vitorr-hugoo/TCC/tools/README.md

# Ferramentas

- `hardware/`: scripts de apoio e validacao do KiCad.
- `documentos/`: geradores de documentos e figuras.
- `codex/skills/`: instrucoes reutilizaveis para automacao assistida.

Scripts devem receber ou resolver caminhos dentro do repositorio; resultados
intermediarios devem ser gravados em `../work/`.
