vitorr-hugoo/TCC/docs/engineering/firmware/stm32/reports/004-lora-transicao-standby.md

# LoRa: confirmação da transição para Standby

Após corrigir NSS para PB12, a bancada apresentou `RegVersion=0x12` e
`CONFIG: reg=0x01 esperado=0x81 lido=0x80`. O registrador é RegOpMode:
o firmware pediu LoRa Standby, mas leu LoRa Sleep. Isso localiza a falha;
não comprova, sozinho, defeito elétrico ou atraso de transição.

O driver verificava todas as escritas imediatamente, incluindo mudança de
modo. A saída de Sleep envolve partida do oscilador, descrita no
[datasheet Semtech SX1276/77/78/79](https://cdn-shop.adafruit.com/product-files/3179/sx1276_77_78_79.pdf).
A hipótese a verificar na placa é leitura antes de concluir a transição.

Alteração: após escrever RegOpMode, consultar sua confirmação a intervalos
de 1 ms, com prazo de 10 ms e limite adicional de consultas. O comando é
escrito uma vez; os demais registradores mantêm verificação imediata.
Erro SPI aborta imediatamente. Se não confirmar, mantém CONFIG, mostra
esperado/lido e não habilita transmissão. Os timeouts SPI permanecem
independentes, portanto uma operação SPI em falha pode levar mais que 10 ms.

Validação nativa: 54/54 cenários LoRa aprovados, incluindo quatro novos:
modo atrasado que confirma, modo preso em Sleep, erro SPI durante espera
e timeout atravessando rollover do relógio. Esses testes não reproduzem o
oscilador físico; confirmar gravando o firmware na placa.

Se continuar lendo 0x80 depois do prazo, investigar alimentação, RESET e
oscilador/configuração de clock do módulo, sem simplesmente ampliar o prazo
ou ignorar a verificação. Sem commit, push, alteração do pacote ou ACK.

Builds ARM Debug e Release concluídos sem erros; permanece apenas o aviso anterior do FatFs em ff.c:5032.

## Retorno da bancada

O usuario confirmou inicializacao LoRa bem-sucedida e validou o TX do STM32 apos o ajuste. O log apresentou `Init OK` e `TX concluida pelo radio | seq=0 | len=18 | motivo=OK`. Mantido o prazo de 10 ms para confirmacao da transicao; ele nao e atraso fixo. Essa validacao confirma o caminho local de TX, sem constituir ACK de entrega do gateway.
