vitorr-hugoo/TCC/docs/tcc/fontes/Projeto_alimentacao_VRLA_TCC.docx

# Projeto de alimentacao para placa de TCC com bateria VRLA AGM

Documento de arquitetura, circuitos de referencia, seguranca e implementacao no KiCad

Versao atualizada para bateria chumbo-acida regulada por valvula, 12 V, tipo AGM

Decisao de projeto. A referencia deste documento e uma bateria VRLA AGM de 12 V e 7 Ah, instalada fora da area mais quente da caixa. O painel solar e uma fonte externa de 15 a 18 Vcc alimentam um carregador discreto. A bateria fornece o barramento VSYS, que varia com o estado de carga; a placa gera 5 V e 3,3 V a partir dele.

Limite de escopo. Nao ha rede CA dentro da PCB. A energia eletrica externa deve chegar por uma fonte AC/DC certificada, em baixa tensao continua. Valores de carga e protecao devem ser confirmados na folha de dados da bateria adquirida.

Leitura recomendada: comece pela arquitetura na pagina seguinte, depois escolha a bateria real e ajuste o carregador e o corte por subtensao. As notas [R1] a [R7] aparecem explicitamente nas secoes tecnicas e sao listadas ao fim.

# 1 Arquitetura recomendada

O encadeamento correto nao e painel solar ou fonte de 12 V -> buck -> bateria. Uma VRLA de 12 V exige tensao de carga maior que 12 V. Por isso, as fontes entram primeiro em um carregador dedicado; a bateria fica entre o carregador e os reguladores da placa. O carregador e construido com CI, MOSFETs, indutor, passivos e sensores na propria PCB, sem modulo pronto.

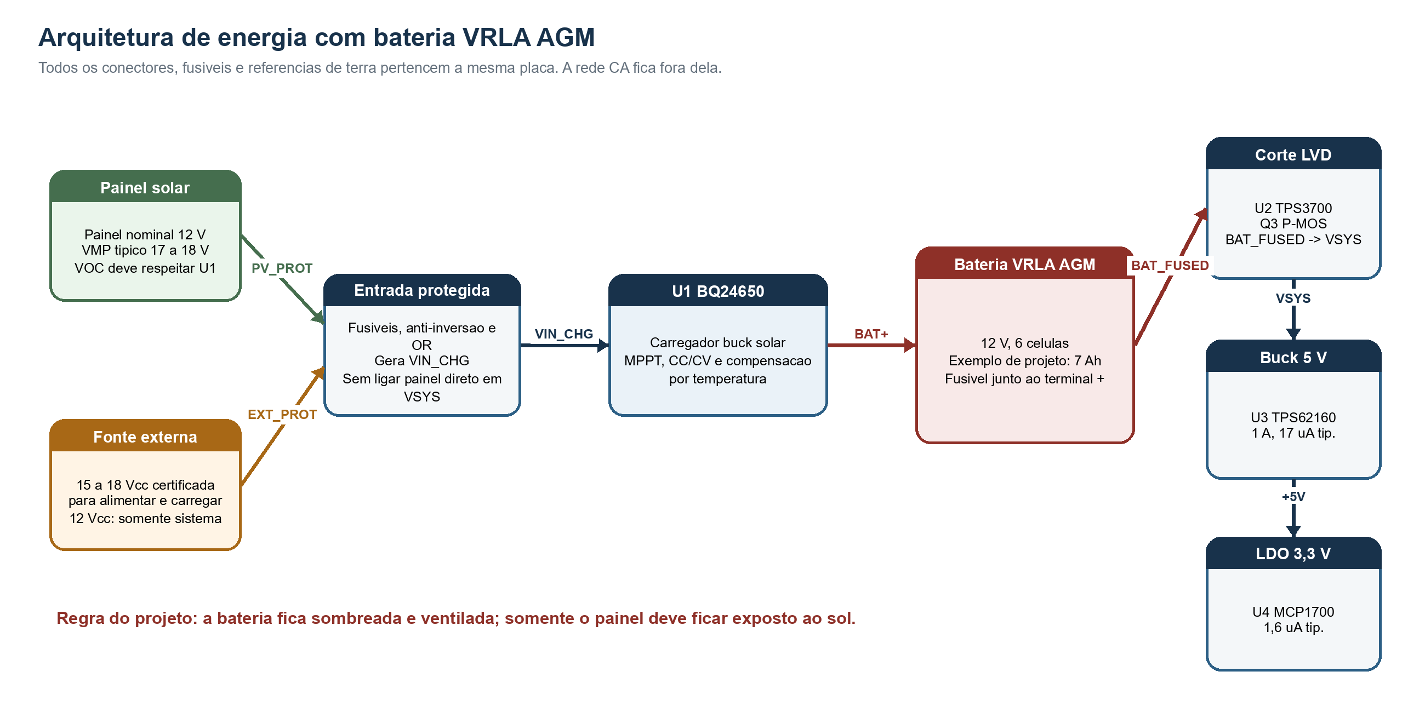
[picture p14: figure]

Figura 1 - Fluxo de energia e nomes dos barramentos. A exposicao solar e exclusiva do painel; a bateria deve permanecer sombreada e ventilada.

Ponto que muda em relacao a Li-ion. Desaparecem o BMS 3S e o balanceamento de celulas, mas surgem tres itens obrigatorios: perfil de carga bulk/recharge adequado, compensacao por temperatura e corte de descarga profunda. A VRLA ainda pode liberar gas pela valvula em condicao anormal de carga; portanto nao deve ficar em um compartimento hermetico. Ver [R3] e [R4].

## 1 1 Barramentos e faixas de tensao

Rede | Faixa esperada | Funcao | Observacao
VIN_CHG | Painel nominal 12 V: VMP tipico 17 a 18 V; VOC conforme painel | Entrada do carregador | Escolher painel cujo VOC maximo fique abaixo de 28 V, limite de entrada de U1 [R1].
BAT+ | Cerca de 10,5 a 14,7 V | Terminal da VRLA | Nao e um 12 V regulado. A tensao depende de carga, descarga e temperatura.
VSYS | Cerca de 11,3 a 14,7 V | Entrada dos reguladores | Sai apos fusivel e LVD. Abaixo do limiar o sistema desliga.
+5V | 5,0 V regulados | Sensores e perifericos de 5 V | Gerado por buck U3.
+3V3 | 3,3 V regulados | MCU, LoRa, SD e logica | Gerado por LDO U4; avaliar dissipacao.

# 2 Bateria VRLA AGM e seguranca

VRLA significa valve regulated lead acid. AGM e uma forma de VRLA em que o eletrólito fica absorvido em manta de fibra de vidro. Ela e mais apropriada que uma bateria inundada para este projeto porque nao exige reposicao de agua e tem invólucro selado, mas continua sendo uma bateria chumbo-acida e possui valvulas de alivio de gas.

## 2 1 Bateria de referencia

Para dimensionar os valores exemplificados, foi usada como referencia uma VRLA AGM 12 V e 7 Ah, similar a Power Sonic PS-1270. Essa bateria e somente um ponto de partida: a marca e o modelo finais governam tensoes, corrente de carga, temperatura e limiares definitivos. A PS-1270 publica 14,1 a 14,4 V para carga ciclica, 13,5 a 13,8 V para flutuacao, corrente inicial maxima de 2,1 A e energia nominal de 84 Wh a 20 h [R3].

Parametro de projeto | Valor de referencia | Como usar
Capacidade | 7 Ah a taxa de 20 h | Usar para estimativa inicial. A capacidade util cai com corrente alta e temperatura baixa.
Corrente bulk inicial | 0,7 A (aprox. C/10) | Escolha conservadora para painel de 20 a 30 W. Fica abaixo do limite de 2,1 A do exemplo [R3].
Tensao bulk/ciclica | 14,4 V a 20 C | Ajustar o divisor VFB do carregador. Nunca aplicar este numero a outra bateria sem conferir seu datasheet.
Tensao de manutencao | 13,7 V a 20 C | Usada como VRECH/FLOAT no algoritmo de pulsos de U1.
Compensacao termica | Usar valor do fabricante | No exemplo PS-1270: -30 mV/C em ciclica e -18 mV/C em flutuacao [R3].

## 2 2 Instalacao fisica segura

- Instalar a bateria fora da PCB e fora da incidencia solar direta, em compartimento sombreado e ventilado. O painel e o elemento que deve receber sol.
- Nao selar a bateria dentro de uma caixa hermetica. Baterias VRLA podem liberar hidrogenio; o fabricante alerta para risco de mistura explosiva e pede que nao sejam colocadas em recipiente fechado [R4].
- Fixar a bateria mecanicamente e manter os terminais protegidos contra contato acidental. Os cabos do positivo devem ser curtos e ter fusivel junto ao terminal positivo.
- Manter a bateria afastada de fontes de calor, do indutor do carregador e de conectores que possam gerar faisca. O NTC de medicao deve tocar a lateral da bateria, nao o ar da caixa.
- Providenciar reciclagem adequada no fim da vida. Chumbo e eletrólito nao devem ser descartados no lixo comum [R4].

Nota termica. A faixa de operacao recomendada para VRLA pela Yuasa e 10 a 30 C, com 20 C como condicao de referencia; temperaturas mais altas reduzem a vida util [R4]. No projeto, bloquear a carga quando a bateria exceder o limite de seu fabricante e registrar essa temperatura no firmware, se houver ADC disponivel.

# 3 Entradas de energia antes do carregador

A folha de alimentacao deve desenhar as entradas a esquerda e os reguladores a direita. Nao usar a rotulacao 12 V para a entrada solar, porque um painel nominal de 12 V trabalha perto de 17 a 18 V no ponto de maxima potencia. O seu VOC pode ser maior e deve ser conferido no painel real.

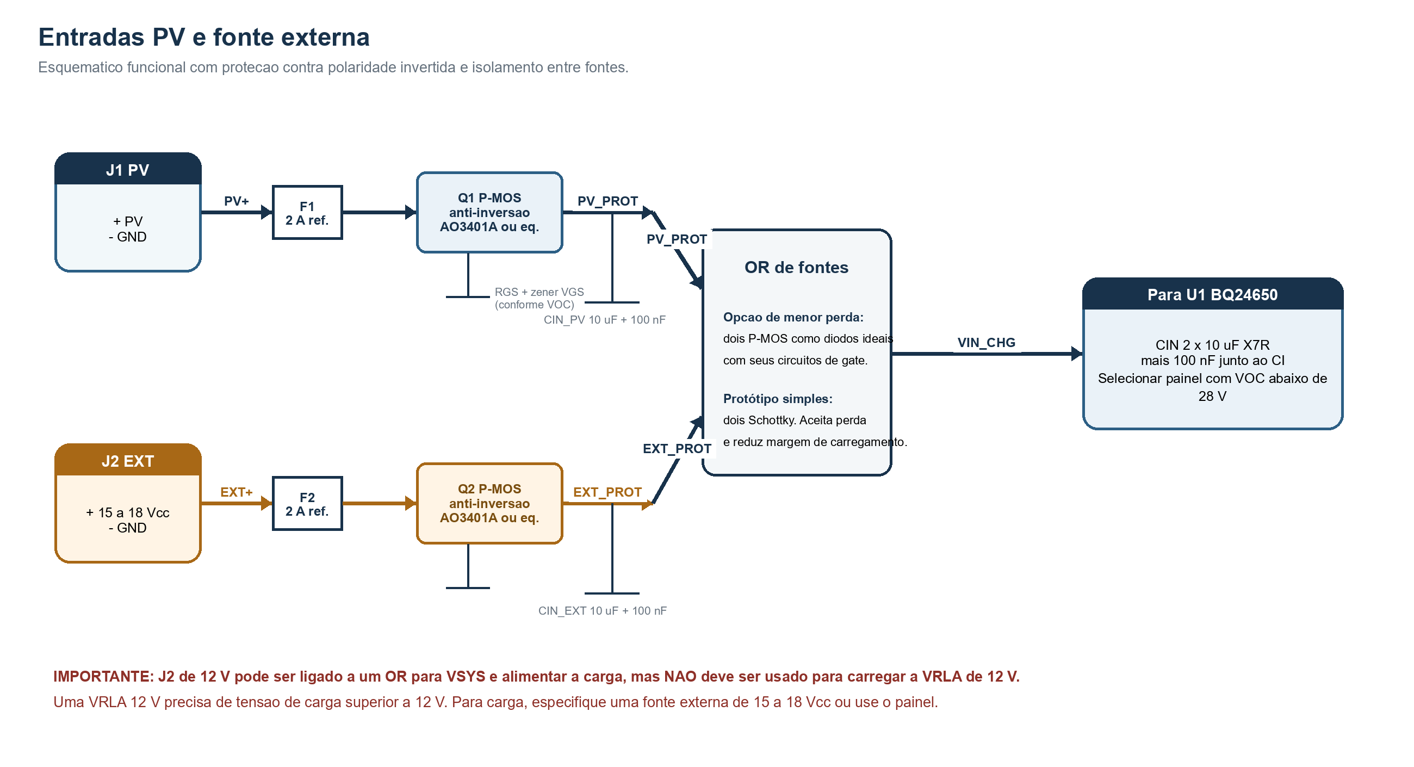
[picture p15: figure]

Figura 2 - Entradas e OR de fontes. O OR impede que uma fonte empurre corrente para a outra.

## 3 1 Painel e fonte externa

- J1 PV: painel nominal 12 V, com VMP proximo de 17 a 18 V. Confirmar que o VOC maximo, inclusive em temperatura baixa, permanece abaixo de 28 V, conforme a faixa de entrada de U1 [R1].
- J2 EXT para carga: fonte AC/DC externa certificada de 15 a 18 Vcc, com corrente superior a corrente de carga escolhida mais o consumo simultaneo da placa. Ela ocupa o lugar do painel em VIN_CHG.
- Uma fonte de 12 Vcc pode alimentar uma entrada de sistema separada, se desejado, mas nao consegue elevar a VRLA ate 14,1 a 14,4 V. Portanto, nao a ligar diretamente ao carregador esperando recarga completa.
- F1 e F2: o valor definitivo depende da corrente do painel/fonte e da bitola. Para painel de 20 a 30 W, 2 A e uma referencia inicial, nao uma especificacao universal.

TVS de entrada. Nao foi fixado um codigo de TVS neste documento. Em painel de 18 V, muitos TVS com tensao de trabalho suficiente grampeiam acima do maximo absoluto de 28 V do BQ24650. A protecao contra surto deve ser selecionada depois de conhecer VOC, cabo e ambiente. Para a primeira placa, use cabo curto, painel com VOC dentro da especificacao e a rede de entrada recomendada pelo fabricante de U1 [R1].

# 4 Carregador solar discreto

O BQ24650 e um controlador buck para carregamento a partir de painel solar, com rastreio de ponto de maxima potencia. Ele requer MOSFETs externos, indutor, resistor de corrente, capacitores e rede de programacao; isto atende ao requisito de nao usar modulo comercial pronto. A TI publicou uma nota de aplicacao especifica para adaptar esse CI a uma bateria chumbo-acida selada [R2].

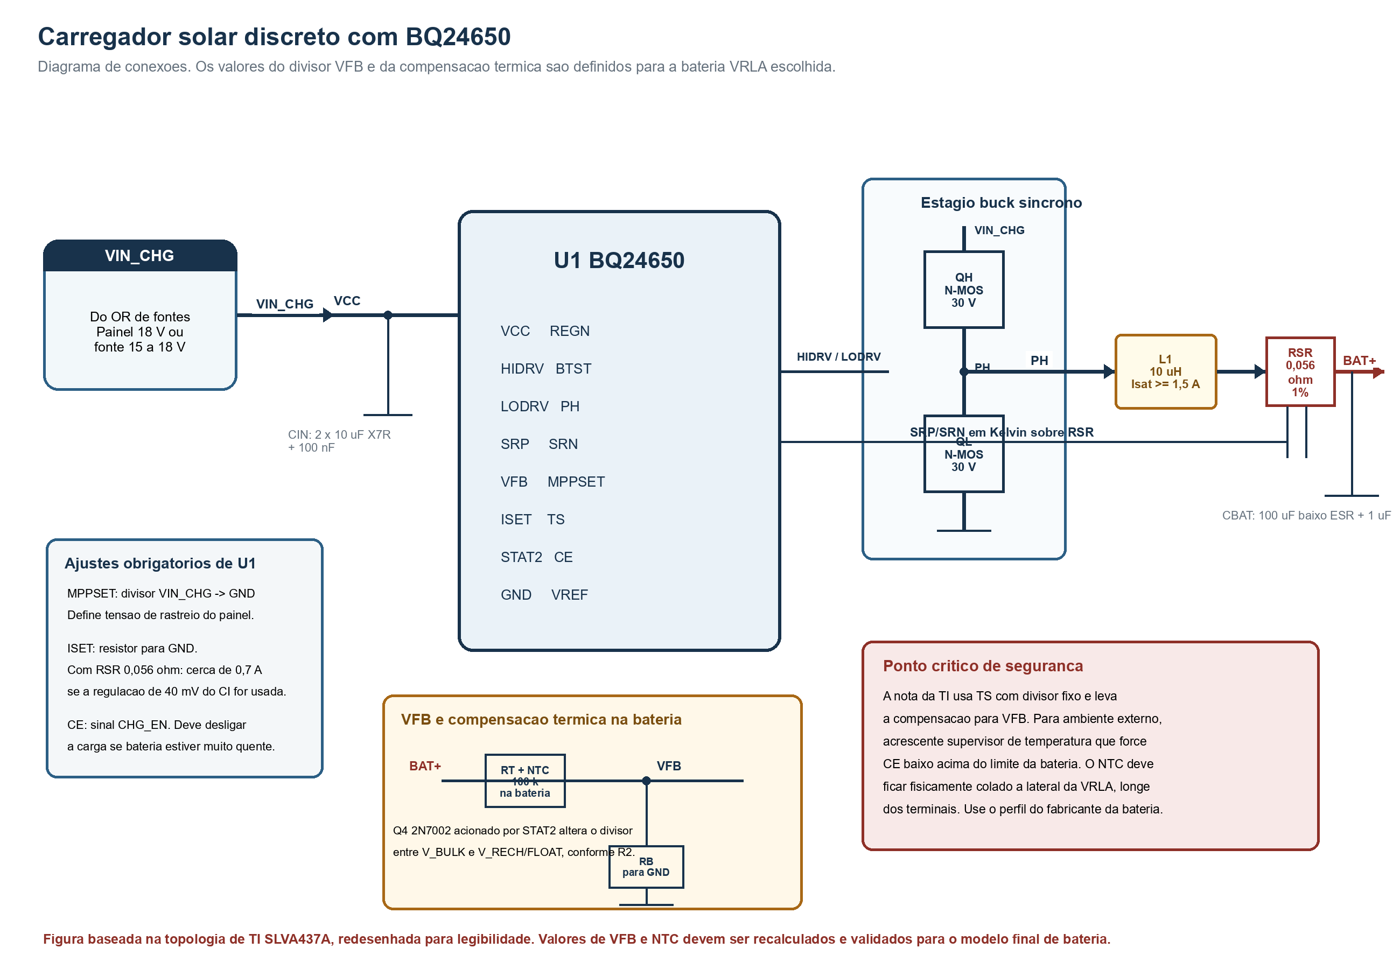
[picture p16: figure]

Figura 3 - Circuito de referencia do carregador. As redes de VFB, NTC e STAT2 implementam os pontos de carga e manutencao da VRLA.

## 4 1 Perfil de carga

Etapa | Acao de U1 | Referencia 7 Ah AGM | Objetivo
Bulk CC | Regula corrente pelo resistor RSR | 0,7 A | Recuperar bateria descarregada sem exceder o limite da bateria e do painel.
CV bulk | Regula VFB no ponto alto | 14,4 V a 20 C | Completar a carga. A corrente cai gradualmente.
Termino | STAT2 muda quando corrente cai | Cerca de C/30, conforme perfil final | Evitar manter tensao bulk por tempo excessivo.
Recharge/floating | STAT2 altera a rede VFB e o carregador entra em pulsos | 13,7 V a 20 C | Manter a bateria sem sobrecarga continua. Conferir compatibilidade com o fabricante.

Como a rede funciona. A nota [R2] usa carga em corrente constante ate a bateria atingir V_BULK. Depois regula tensao; quando a corrente termina, STAT2 desliga Q4 e reduz o ponto de recarga. Ao cair abaixo desse ponto, o CI volta a carregar em pulsos. A rede NTC no divisor VFB altera ambos os pontos com a temperatura. A propria TI adverte que o perfil do fabricante da bateria deve prevalecer.

# 5 Como implementar U1 no esquematico

Crie uma folha hierarquica chamada ALIM 02 CARREGADOR. Use os mesmos nomes de rede da Figura 3. A tabela separa componentes que ja podem ser escolhidos daqueles que dependem do painel e da bateria efetivamente comprados.

Ref. | Componente ou rede | Sugestao inicial | Observacao de projeto
U1 | BQ24650 | CI controlador solar MPPT | Usar layout e componentes basicos do datasheet. O encapsulamento exige soldagem SMD cuidadosa [R1].
QH e QL | MOSFET N 30 V | RDS(on) baixo, logic level, QG compativel | Dimensionar por corrente, tensao e perdas. Manter o loop QH/QL/CIN minimo.
L1 | Indutor do carregador | 10 uH, Isat >= 1,5 A | A margem cobre carga de 0,7 A e ripple. Confirmar pelo calculo do datasheet [R1].
RSR | Resistor de corrente | 0,056 ohm, 1%, 0,25 W | Ponto inicial para aproximadamente 0,7 A quando a referencia de 40 mV for aplicavel. Validar em bancada.
CIN | Capacitores de entrada | 2 x 10 uF X7R mais 100 nF | Colocar junto a QH/QL e GND de U1. Considerar reducao de capacitancia por bias.
CBAT | Capacitor no lado da bateria | 100 uF baixo ESR mais 1 uF | Reduz ripple na bateria e estabiliza a etapa buck.
RMP | Divisor MPPSET | Calcular com VMP real | Define o ponto de rastreio. Nao copiar valor sem conhecer o painel.
RT, RB, NTC, Q4 | Rede de VFB e STAT2 | Seguir SLVA437A e recalcular | Define V_BULK, V_RECH/FLOAT e compensacao. NTC de 100 k e exemplo da TI, nao regra universal.

## 5 1 Valores que nao devem ser copiados cegamente

- O exemplo de [R2] foi feito para uma VRLA de 2,4 Ah e usa V_BULK de 14,85 V e V_RECH de 14,1 V. Esses numeros nao sao automaticamente corretos para uma AGM de 7 Ah.
- Para a bateria de referencia de 7 Ah, usar inicialmente 14,4 V ciclica e 13,7 V de manutencao a 20 C, somente se a folha de dados da bateria final concordar [R3].
- O painel define o divisor MPPSET. Medir VMP e VOC no modelo real; alterar painel implica revisar RMP e a protecao de entrada.
- O NTC deve compensar a bateria e nao a temperatura da PCB. Se a bateria e a placa ficarem fisicamente separadas, levar dois fios de sensor ao conector da bateria.

Verificacao obrigatoria. Antes de conectar a VRLA, testar o carregador com fonte de bancada limitada e carga eletrônica/resistiva. Confirmar V_BULK, V_RECH, corrente de carga, transicao de STAT2 e variacao com NTC. So entao conectar a bateria verdadeira, com fusivel instalado.

# 6 Protecao da bateria e corte por subtensao

A VRLA nao possui BMS de celulas. O corte de descarga profunda e, portanto, uma funcao da sua placa. U2 monitora BAT_FUSED antes da chave de carga e comanda Q3. Isso desliga a eletrônica quando a bateria cai e reduz o risco de descarga lenta continua durante a noite.

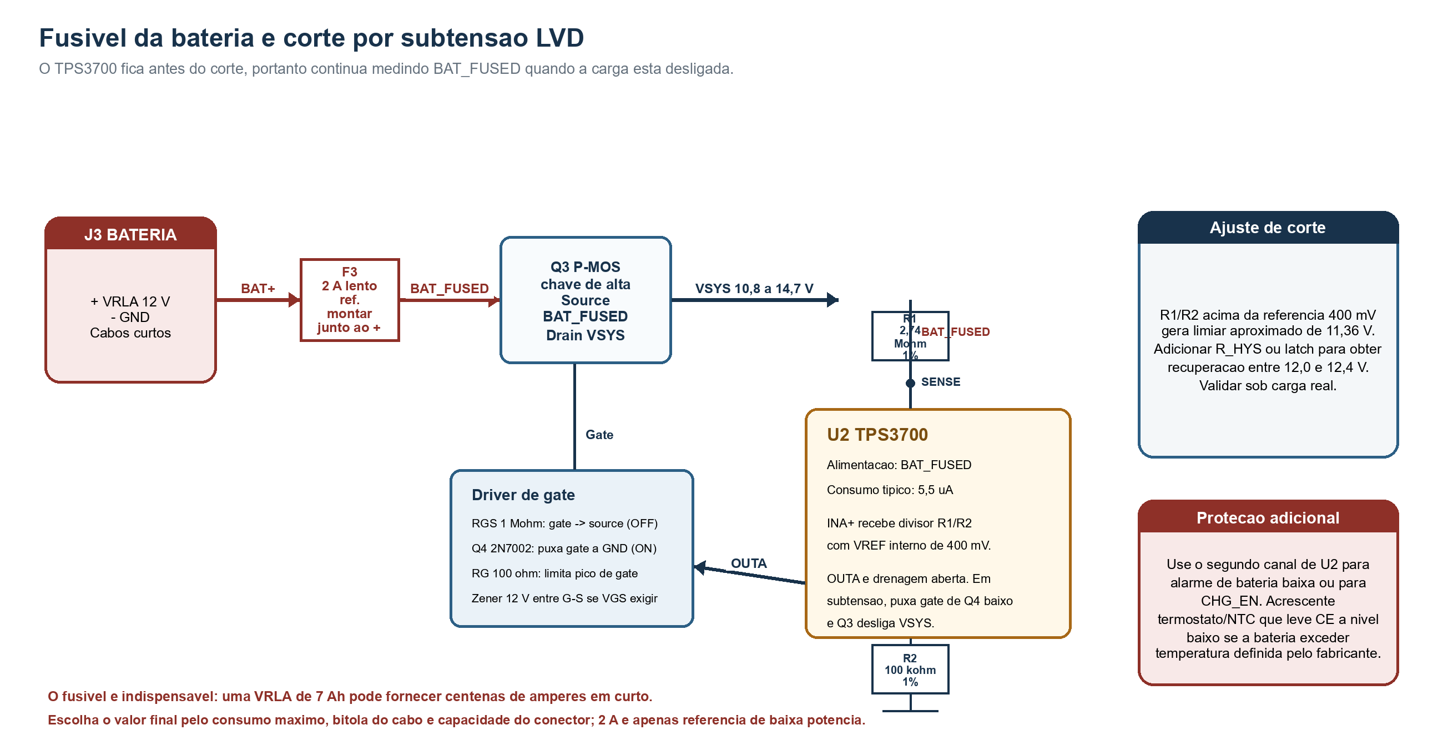
[picture p17: figure]

Figura 4 - Fusivel e LVD. O supervisor e alimentado antes de Q3, permitindo que VSYS seja desligado e depois religado quando a bateria se recuperar.

## 6 1 Escolha de limiares

O divisor R1/R2 mostrado usa a referencia interna de 400 mV do TPS3700 e coloca o limiar base perto de 11,36 V. Esse valor e uma partida para uma AGM de 12 V em carga leve, nao um valor garantido de estado de carga. A tensao em carga cai por resistencia interna e por corrente do sistema.

Sinal | Alvo inicial | Uso
Aviso BAT_LOW | 11,8 a 12,0 V sob condicao definida | Enviar ao MCU, reduzir telemetria e registrar evento.
Corte VSYS | Aproximadamente 11,3 a 11,5 V | Q3 abre e remove carga eletrônica. Ajustar com teste de autonomia e bateria real.
Religamento | 12,0 a 12,4 V ou apos carga | Usar R_HYS ou latch. Evita liga/desliga repetitivo devido a recuperacao elástica.
Carga quente | Limite do fabricante | Levar CHG_EN/CE para desabilitar o carregador. Em campo quente, nao ignorar esse sinal.

Componente recomendado. TPS3700 e uma alternativa de baixo consumo para o LVD porque opera de 1,8 a 18 V e consome tipicamente 5,5 uA, com saídas open-drain [R5]. AO3401A e 2N7002 sao opcoes comuns e baratas para a chave P-MOS e seu driver, desde que as margens de VDS, VGS e corrente sejam conferidas no lote adquirido.

# 7 Reguladores de 5 V e 3,3 V

O barramento VSYS de uma VRLA nao deve alimentar diretamente circuitos de 5 V ou 3,3 V. A sequencia recomendada e VSYS -> buck 5 V -> LDO 3,3 V. O buck reduz a perda principal, e o LDO fornece um rail simples e de corrente de repouso muito baixa para a logica.

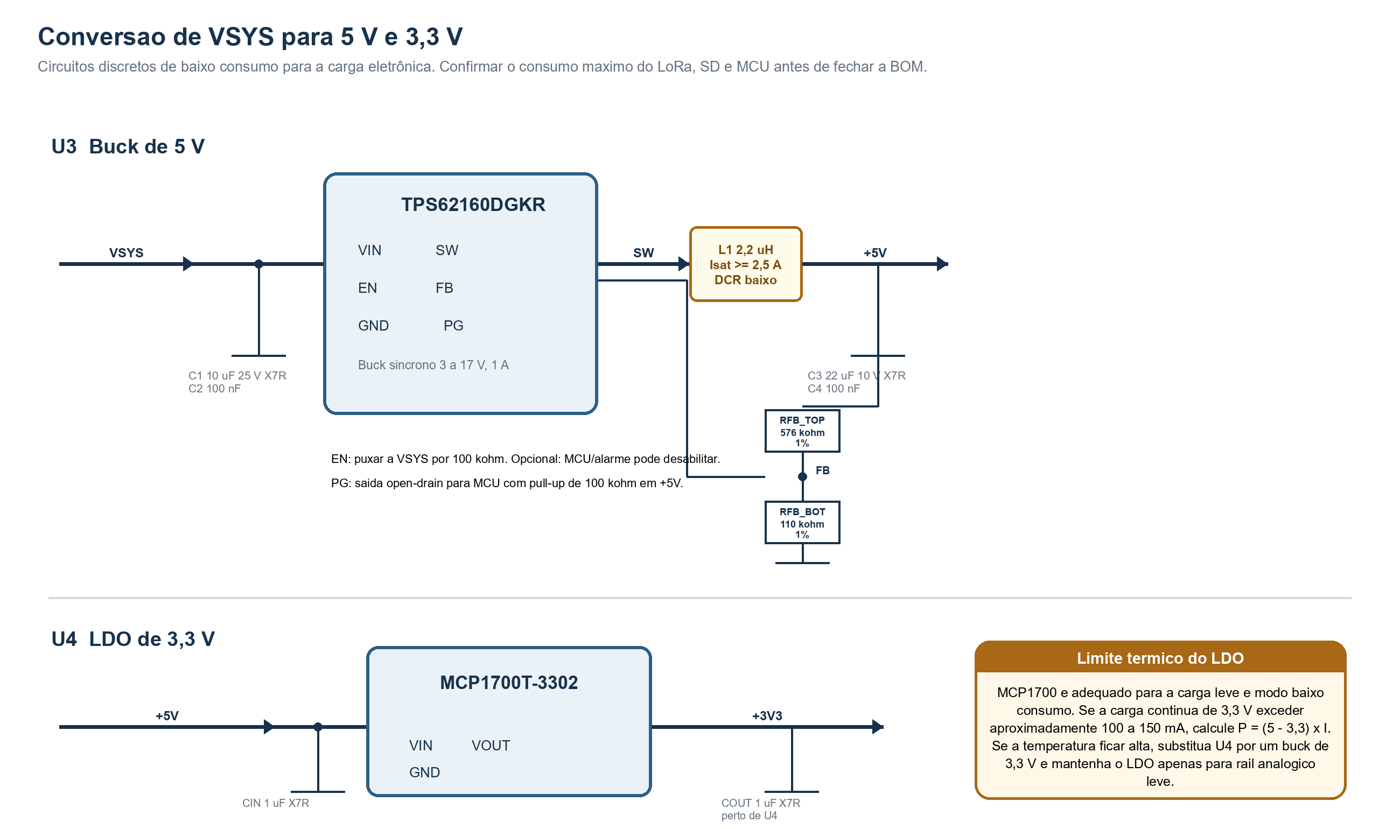
[picture p18: figure]

Figura 5 - Circuitos de 5 V e 3,3 V. Os valores do buck seguem o uso de 5 V ajustaveis e devem ser confrontados com o datasheet do CI antes da PCB final.

## 7 1 Escolha dos reguladores

Bloco | CI recomendado | Por que | Atenção
Buck 5 V | TPS62160DGKR | Entrada 3 a 17 V, saida ate 1 A e Iq tipico de 17 uA [R6]. Encapsulamento VSSOP e mais montavel que WSON. | A entrada de 17 V deixa margem para VRLA ate 14,7 V, mas nao para surto sem analise.
LDO 3,3 V | MCP1700T-3302 | Ate 250 mA e Iq tipico 1,6 uA; estavel com 1 uF [R7]. Bom para standby e carga leve. | Avaliar calor para consumo continuo alto em 3,3 V.
Nao recomendado | AMS1117 | Muito popular e barato, mas corrente quiescente na ordem de mA nao favorece autonomia. | Nao usar como regulador low power da placa.

Dissipacao do LDO. Calcule P_LDO = (5,0 - 3,3) x I_3V3. Em 150 mA, a perda e aproximadamente 0,255 W. Se o LoRa, SD e MCU mantiverem consumo alto por tempo prolongado, prefira um buck adicional de 3,3 V e reserve o MCP1700 para sensores analogicos ou standby.

# 8 Como organizar a folha de alimentacao no KiCad

Organize a folha principal da esquerda para a direita e separe os blocos em folhas hierarquicas. Evite um fio longo de painel atravessando toda a pagina. Use etiquetas globais de rede e conectores bem identificados.

Folha | Conteudo | Entradas | Saidas
ALIM 01 ENTRADAS | J1, J2, fusivel, anti-inversao e OR | PV+, EXT+, GND | VIN_CHG
ALIM 02 CARREGADOR | BQ24650, MOSFETs, indutor, NTC e divisores | VIN_CHG, BAT+, CHG_EN | BAT+, STAT, TP_CHG
ALIM 03 BATERIA LVD | J3, F3, TPS3700 e chave P-MOS | BAT+ | BAT_FUSED, VSYS, BAT_LOW
ALIM 04 BUCK 5V | TPS62160 e filtros | VSYS | +5V, PG_5V
ALIM 05 LDO 3V3 | MCP1700 e desacoplamentos | +5V | +3V3

## 8 1 Etiquetas e pontos de teste

- Usar etiquetas: PV_PROT, EXT_PROT, VIN_CHG, BAT+, BAT_FUSED, VSYS, +5V, +3V3, BAT_LOW, CHG_EN, NTC_BAT, PG_5V.
- Adicionar TP_PV, TP_VIN_CHG, TP_BAT, TP_VSYS, TP_5V, TP_3V3 e TP_NTC. Os testes de ajuste sao muito mais seguros quando nao exigem tocar em pinos de CI.
- Manter GND comum, plano de terra continuo e retorno de corrente do carregador separado da referencia de VFB/MPPSET ate um ponto calmo de terra.

## 8 2 Regras de layout

- No carregador, deixar CIN, QH, QL e GND muito proximos. O no PH e ruidoso; manter pequeno e distante de VFB, MPPSET e NTC.
- Ligar SRP e SRN em Kelvin diretamente aos dois lados de RSR. Nao usar o caminho de alta corrente para a medicao.
- Colocar U3, indutor e capacitores de 5 V juntos. O loop VIN-U3-SW-indutor-COUT deve ser compacto.
- Dimensionar trilhas e conectores de BAT+ pelo fusivel e pela corrente maxima. A corrente de curto de uma VRLA e muito maior que o consumo normal.
- Separar fisicamente a bateria da PCB e do indutor. Se ficar dentro do mesmo gabinete, prever entrada/saida de ar sem permitir agua na eletrônica.

# 9 Lista de materiais e custo beneficio

A lista abaixo privilegia componentes amplamente distribuídos e montagem possivel em uma PCB de TCC. Valores de preco nao foram fixados porque variam com fornecedor, quantidade e disponibilidade; a decisao de custo deve considerar tambem o painel, bateria, cabos e gabinete.

Grupo | Item | Recomendacao | Criterio de custo beneficio
Armazenamento | VRLA AGM 12 V 7 Ah | Modelo com datasheet de carga ciclica e float | Mais barata e simples de adquirir que Li-ion montada, mas pesada. Boa para sistema estacionario.
Carga solar | BQ24650 + MOSFETs + L1 | Implementacao discreta conforme [R1] e [R2] | Mais complexa que modulo, porem documentavel, ajustavel e adequada ao requisito do TCC.
Corte de bateria | TPS3700 + AO3401A + 2N7002 | Baixo Iq e componentes pequenos | Evita substituir bateria precocemente por descarga profunda.
5 V | TPS62160DGKR | VSSOP, L 2,2 uH, X7R | Bom compromisso entre Iq, eficiencia e dificuldade de montagem.
3,3 V | MCP1700T-3302 | SOT-23, 1 uF entrada/saida | Muito baixo consumo e barato; avaliar corrente continua.
Protecao | Fusiveis, conectores e NTC | Nao economizar nestes itens | Sao pequenos no custo e determinantes para seguranca e manutencao.

Conclusao de custo. A VRLA AGM tem melhor custo inicial quando o peso nao importa. O custo total piora se ela for profundamente descarregada todos os dias ou ficar quente; por isso carregamento correto, sombra e LVD nao sao opcional. Para uma estacao meteorologica fixa, esse conjunto e uma escolha defensavel e de boa relacao custo beneficio.

## 9 1 Estimativa simples de autonomia

Para uma bateria de 7 Ah, energia nominal aproximada e 12 V x 7 Ah = 84 Wh. Para preservar vida util, trabalhar inicialmente com 50% de descarga diaria: 42 Wh. Considerando 85% para perdas de conversao, energia em carga aproximada: 36 Wh. Autonomia aproximada = 36 Wh / potencia media da placa. Exemplo: com media de 2 W, cerca de 18 h. Medir a potencia real em modo de transmissao, escrita SD e sono antes de definir o painel.

# 10 Plano de testes e criterios de aceite

O primeiro comissionamento deve reduzir a energia disponivel e validar cada bloco isoladamente. Uma VRLA pode fornecer corrente alta; nao usar curto acidental como teste de fusivel.

Ordem | Teste | Criterio de aceite
1 | Inspecao e continuidade | Sem curto entre BAT+, VIN_CHG, VSYS, +5V, +3V3 e GND. Polaridade de Q3, QH/QL e diodos conferida.
2 | Buck 5 V com fonte limitada | Aplicar 12 a 14,7 V em VSYS com limite de corrente baixo. Confirmar 5,0 V e ripple aceitavel antes de conectar carga.
3 | LDO 3,3 V | Confirmar 3,3 V com carga leve e medir temperatura. Verificar consumo em standby.
4 | LVD | Variar BAT_FUSED lentamente. Registrar desligamento, religamento e ausencia de oscilacao. Ajustar R_HYS/latch se necessario.
5 | Carregador sem bateria | Com fonte limitada em VIN_CHG, conferir sinais de gate, tensao de VFB e ausencia de aquecimento anormal.
6 | Carregador com carga simulada | Usar carga capaz de absorver corrente. Medir limite CC e ponto CV; conferir CHG_EN e NTC.
7 | Bateria real e painel | Conectar bateria com fusivel. Medir corrente, V_BULK, V_RECH, temperatura e tensao do painel em diferentes irradiancias.

Criterio final. O projeto so deve ficar fechado quando os limiares e a temperatura forem medidos no modelo real de bateria, painel, caixa e cabos. Os valores deste documento sao um ponto de partida de engenharia, nao substituem a especificacao da bateria comprada.

# 11 Notas de referencia

As notas abaixo sao citadas explicitamente ao longo do texto. Elas foram usadas para escolher a topologia e os valores de referencia; a folha de dados da bateria efetivamente adquirida continua sendo a autoridade para tensao, corrente e temperatura.

[R1] Texas Instruments. BQ24650, controlador solar buck com MPPT. Base para faixa de entrada, componentes externos e procedimento de projeto. https://www.ti.com/lit/ds/symlink/bq24650.pdf

[R2] Texas Instruments. SLVA437A, Using the bq24650 to Charge a Sealed, Lead-Acid Battery. Base para carga CC/CV, transicao por STAT2, pulsos de recarga e compensacao termica na rede VFB. https://www.ti.com/lit/an/slva437a/slva437a.pdf

[R3] Power Sonic. PS-1270, VRLA AGM 12 V 7 Ah. Referencia de tensoes ciclica e float, limite de corrente, capacidade e advertencias de uso. O modelo foi usado como exemplo, nao como compra obrigatoria. https://www.power-sonic.com/product/ps-1270/

[R4] GS Yuasa. Operating Instructions for VRLA batteries. Referencia para temperatura recomendada, compensacao de carga, ventilacao, gases e reciclagem. https://www.yuasa.com/media/akeneo_connector/asset_files/O/p/Operating_Instructions_EN_ENL_UXF_H_L_9947.pdf

[R5] Texas Instruments. TPS3700, detector de janela de tensao de 1,8 a 18 V, referencia interna de 400 mV e corrente quiescente tipica de 5,5 uA. Base do LVD. https://www.ti.com/lit/ds/symlink/tps3700.pdf

[R6] Texas Instruments. TPS62160, buck 3 a 17 V, 1 A, corrente quiescente tipica de 17 uA. Base do regulador de 5 V. https://www.ti.com/lit/ds/symlink/tps62160.pdf

[R7] Microchip. MCP1700, LDO de baixa corrente quiescente, ate 250 mA e 1,6 uA tipicos. Base do regulador de 3,3 V. https://ww1.microchip.com/downloads/en/DeviceDoc/MCP1700-Data-Sheet-20001826F.pdf

# 12 Pendencias antes de fabricar

- Escolher o modelo exato de painel e registrar VMP, VOC, corrente de curto e potencia nominal.
- Escolher o modelo exato de VRLA AGM e substituir os valores de V_BULK, VRECH/FLOAT, I_BULK, temperatura e NTC pelos do fabricante.
- Calcular RMP, VFB, R_HYS e componentes de potencia com a ferramenta/datasheet de [R1] e a nota [R2].
- Confirmar a corrente maxima simultanea de LoRa, cartao SD, MCU, sensores e eventuais atuadores para fechar o indutor, fusivel, conectores e dissipacao de U4.
- Revisar ERC, DRC e layout de alta corrente antes de gerar a PCB.

Projeto de alimentacao VRLA AGM para TCC
