vitorr-hugoo/TCC/docs/engineering/hardware/alimentacao/esquematicos/esquematico_V4-alimentacao.png

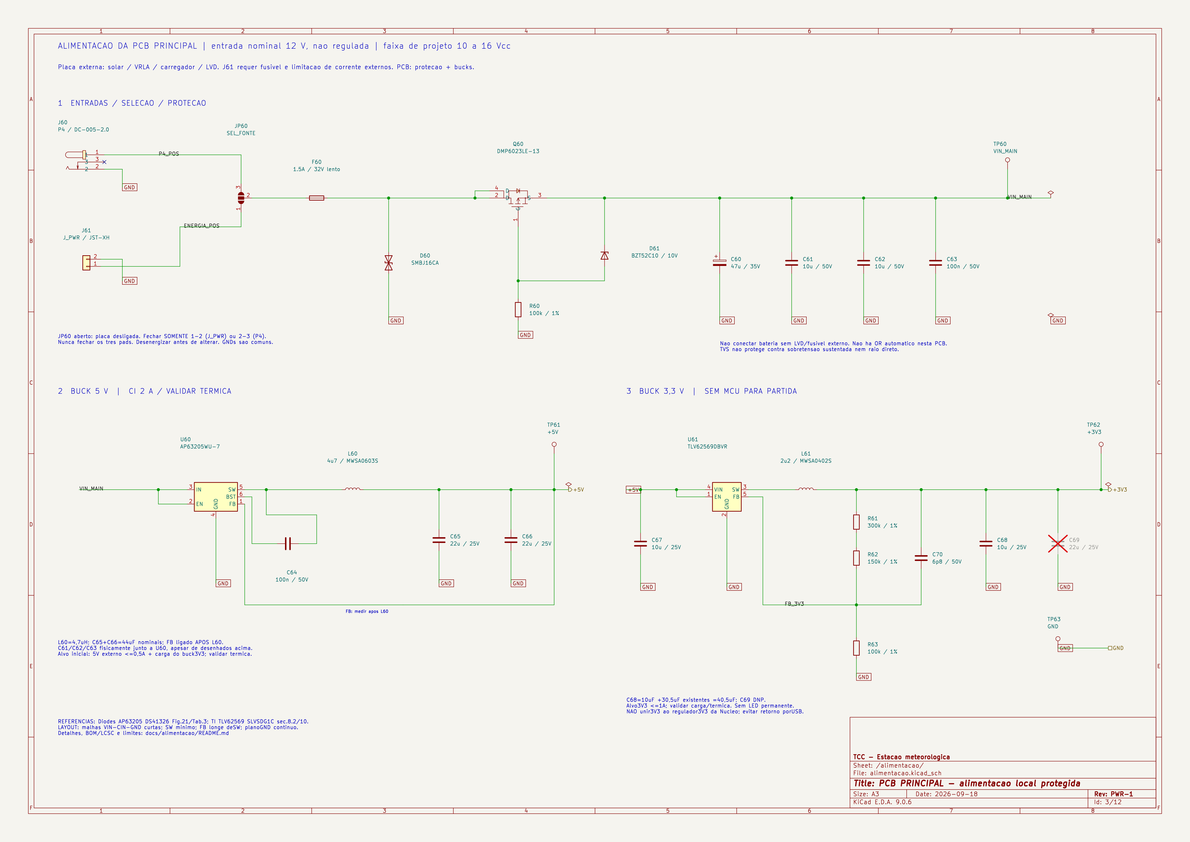
docs/engineering/hardware/alimentacao/esquematicos/esquematico_V4-alimentacao.png
