vitorr-hugoo/TCC/docs/engineering/hardware/alimentacao/esquematicos/esquematico_V4-mcu.png

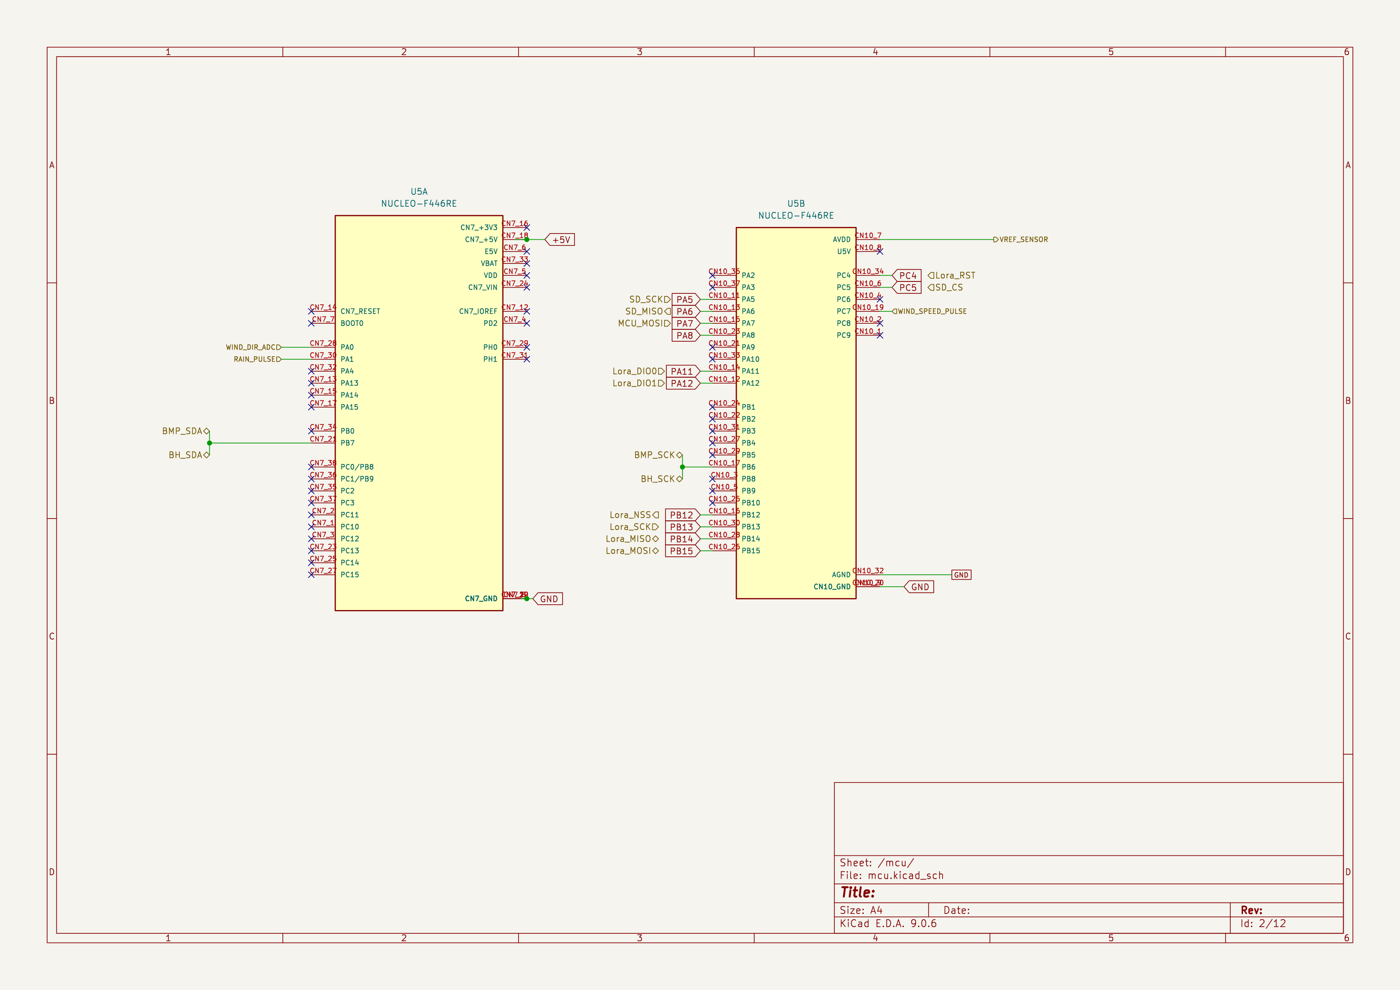
docs/engineering/hardware/alimentacao/esquematicos/esquematico_V4-mcu.png
