vitorr-hugoo/TCC/docs/engineering/hardware/meteorologia/esquematicos/esquematico_V4-METEOROLOGIA-BIRUTA.png

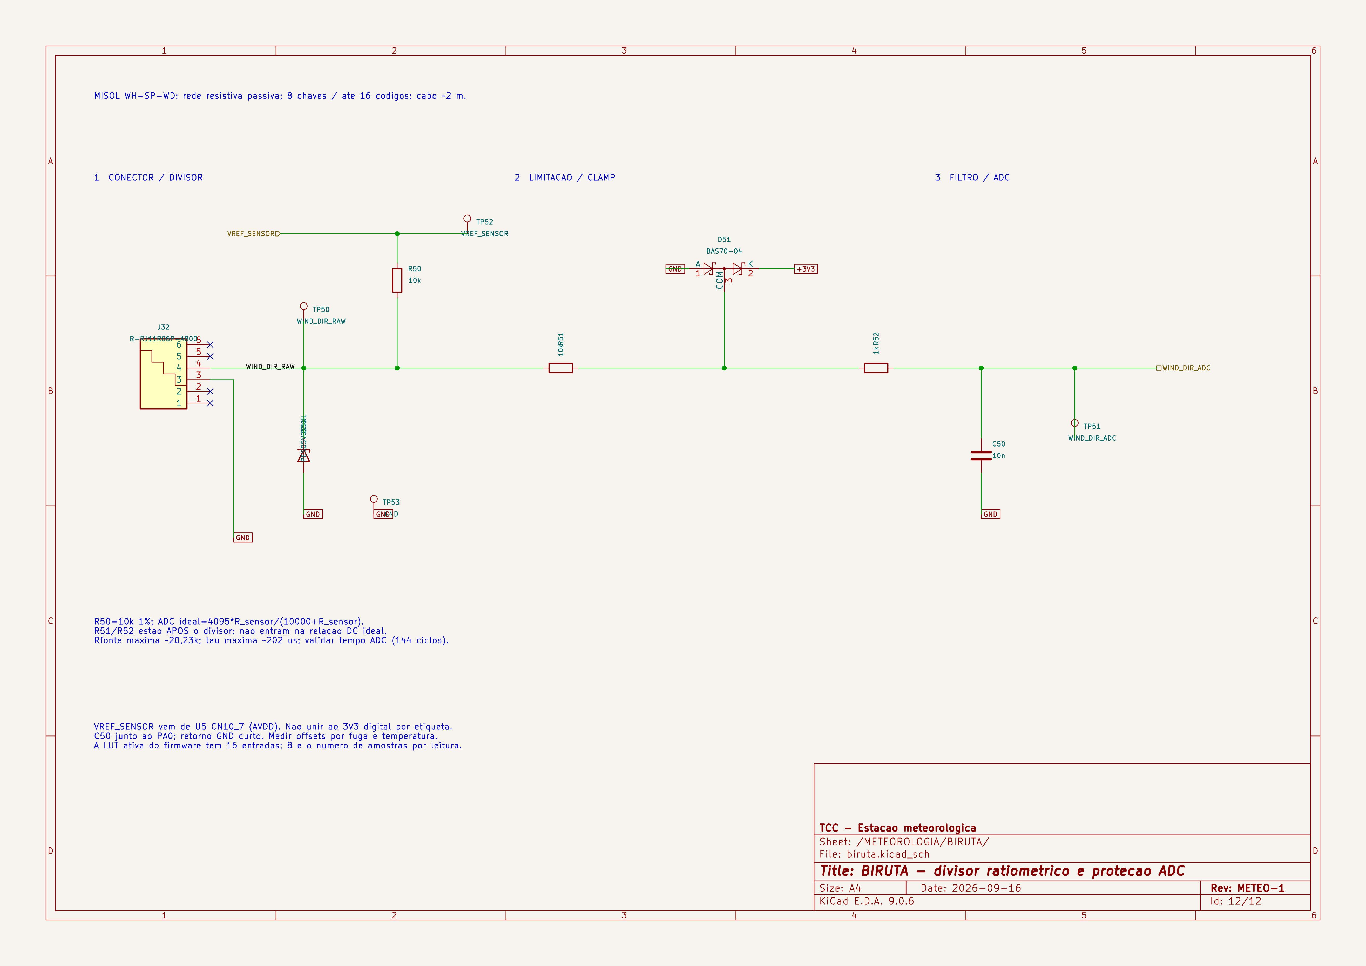
docs/engineering/hardware/meteorologia/esquematicos/esquematico_V4-METEOROLOGIA-BIRUTA.png
