vitorr-hugoo/TCC/docs/engineering/hardware/meteorologia/esquematicos/esquematico_V4.png

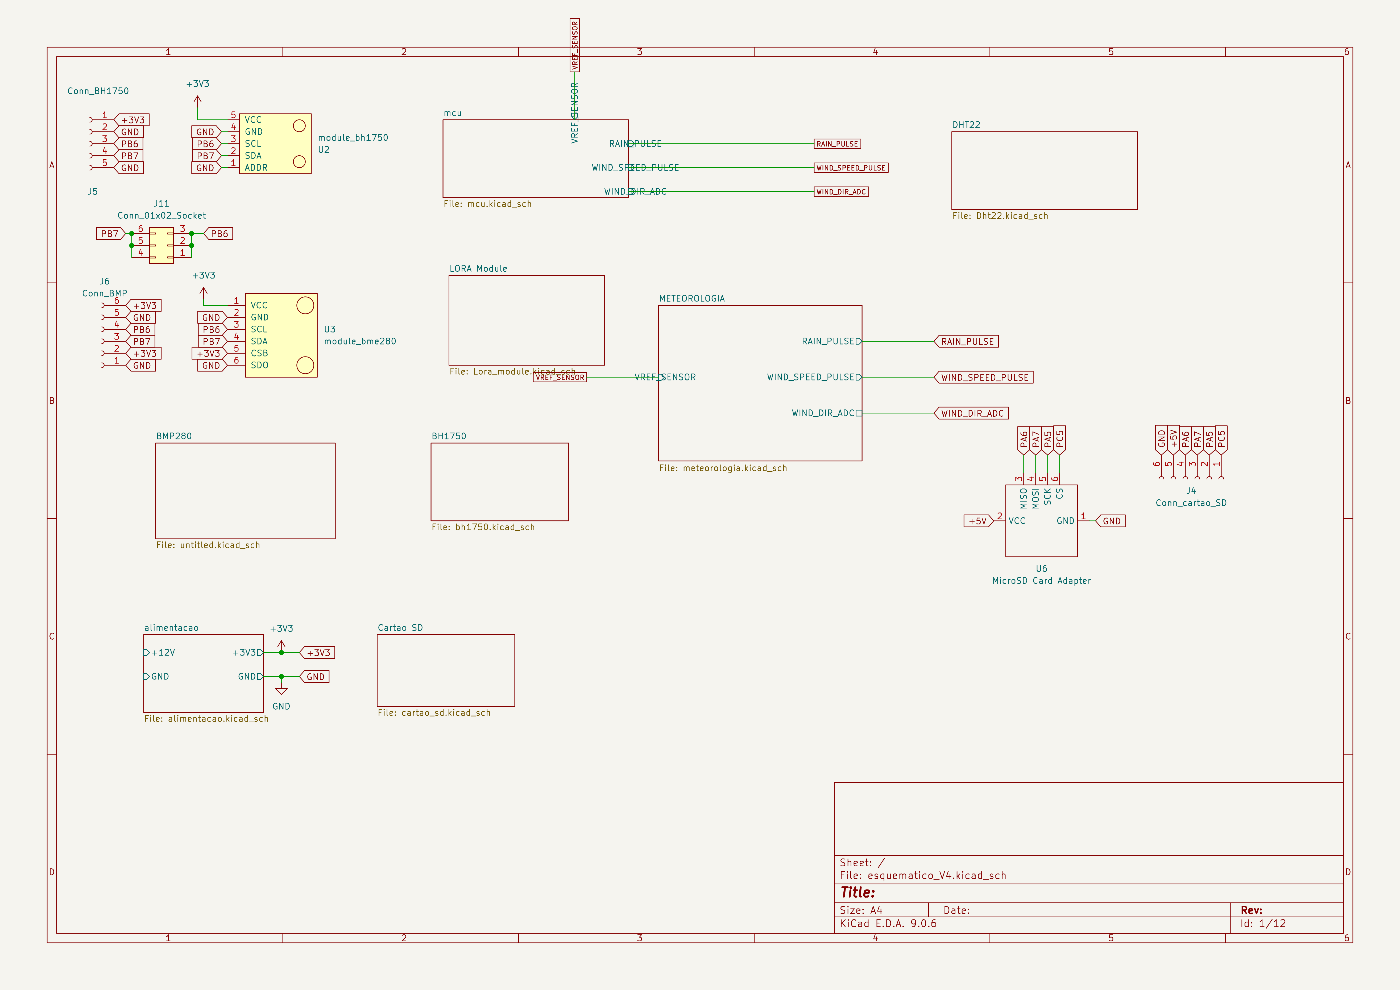
docs/engineering/hardware/meteorologia/esquematicos/esquematico_V4.png
