vitorr-hugoo/TCC/Hardware/docs/alimentacao/esquematicos/esquematico_V4-BH1750.png

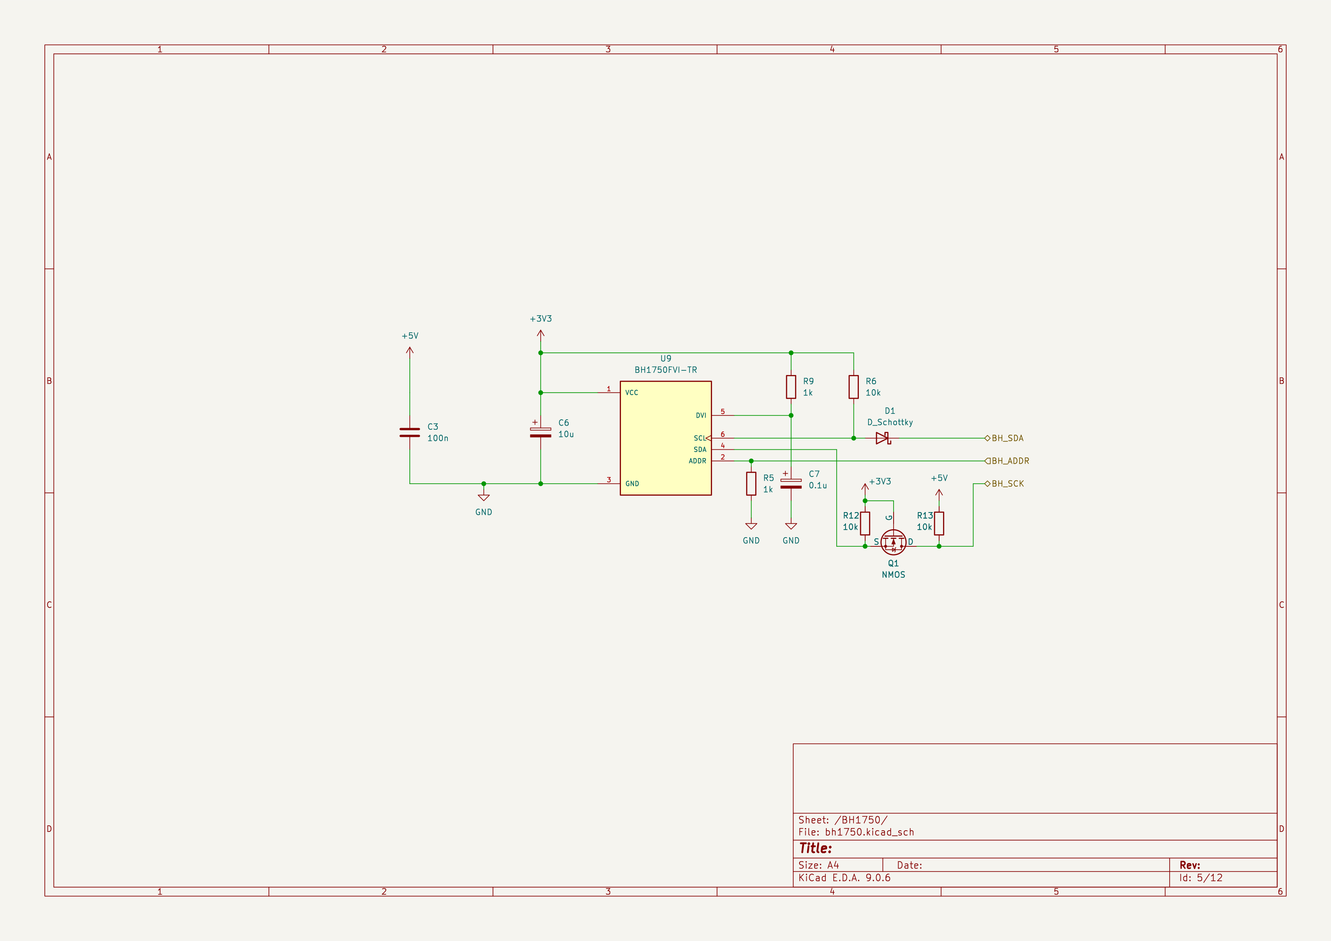
Hardware/docs/alimentacao/esquematicos/esquematico_V4-BH1750.png
