vitorr-hugoo/TCC/Hardware/docs/meteorologia/esquematicos/esquematico_V4-mcu.png

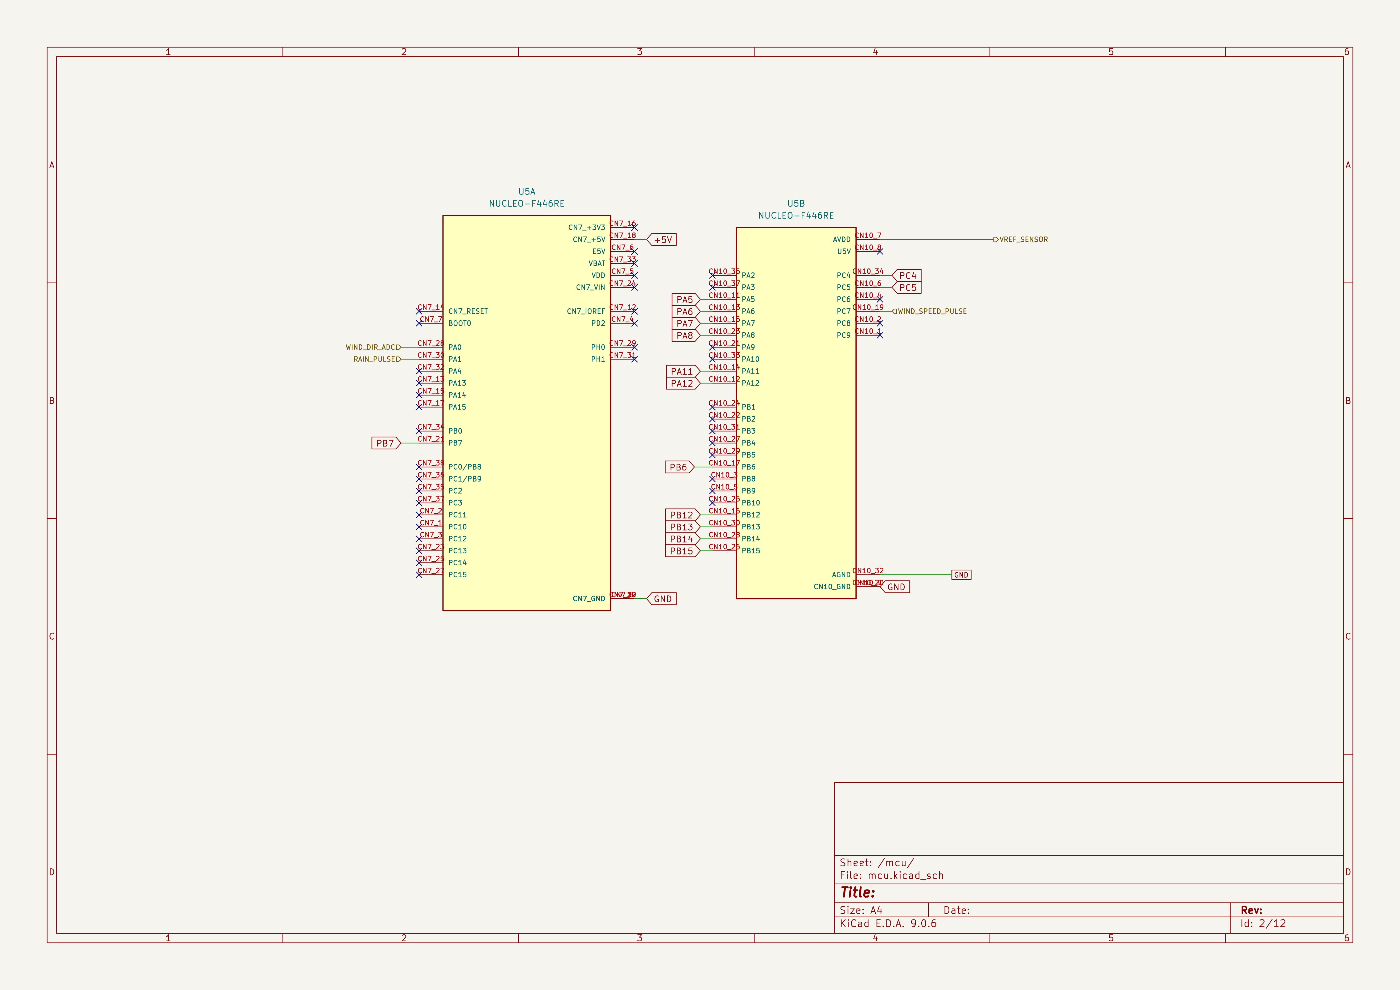
Hardware/docs/meteorologia/esquematicos/esquematico_V4-mcu.png
