vitorr-hugoo/TCC/hardware/kicad/estacao-meteorologica/tmp/bs5-3d.png

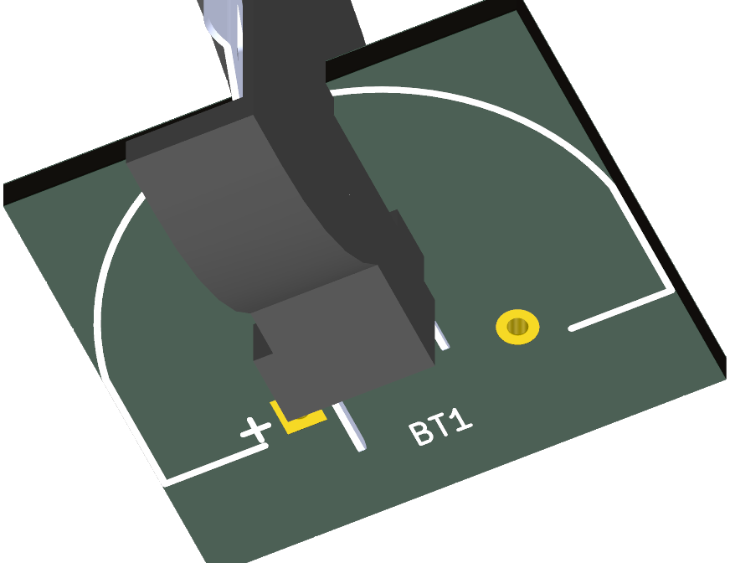
hardware/kicad/estacao-meteorologica/tmp/bs5-3d.png
