vitorr-hugoo/TCC/hardware/kicad/estacao-meteorologica/tmp/bs5-top.png

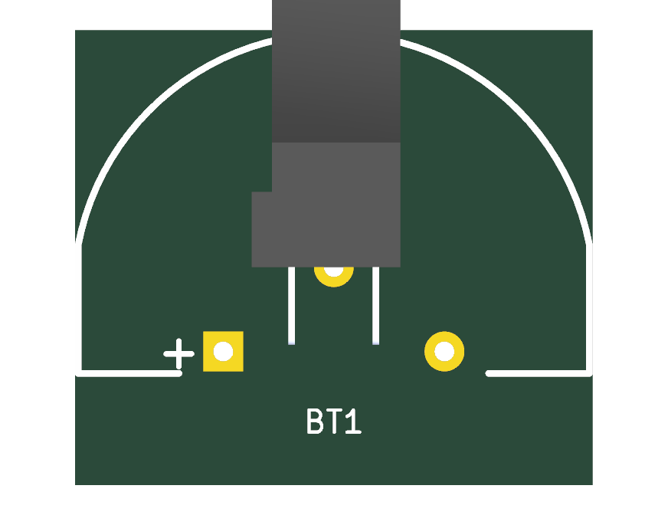
hardware/kicad/estacao-meteorologica/tmp/bs5-top.png
