vitorr-hugoo/TCC/hardware/kicad/estacao-meteorologica/estacao-meteorologica.kicad_pcb

## KiCad design hardware/kicad/estacao-meteorologica/estacao-meteorologica.kicad_pcb (2026-10-13)

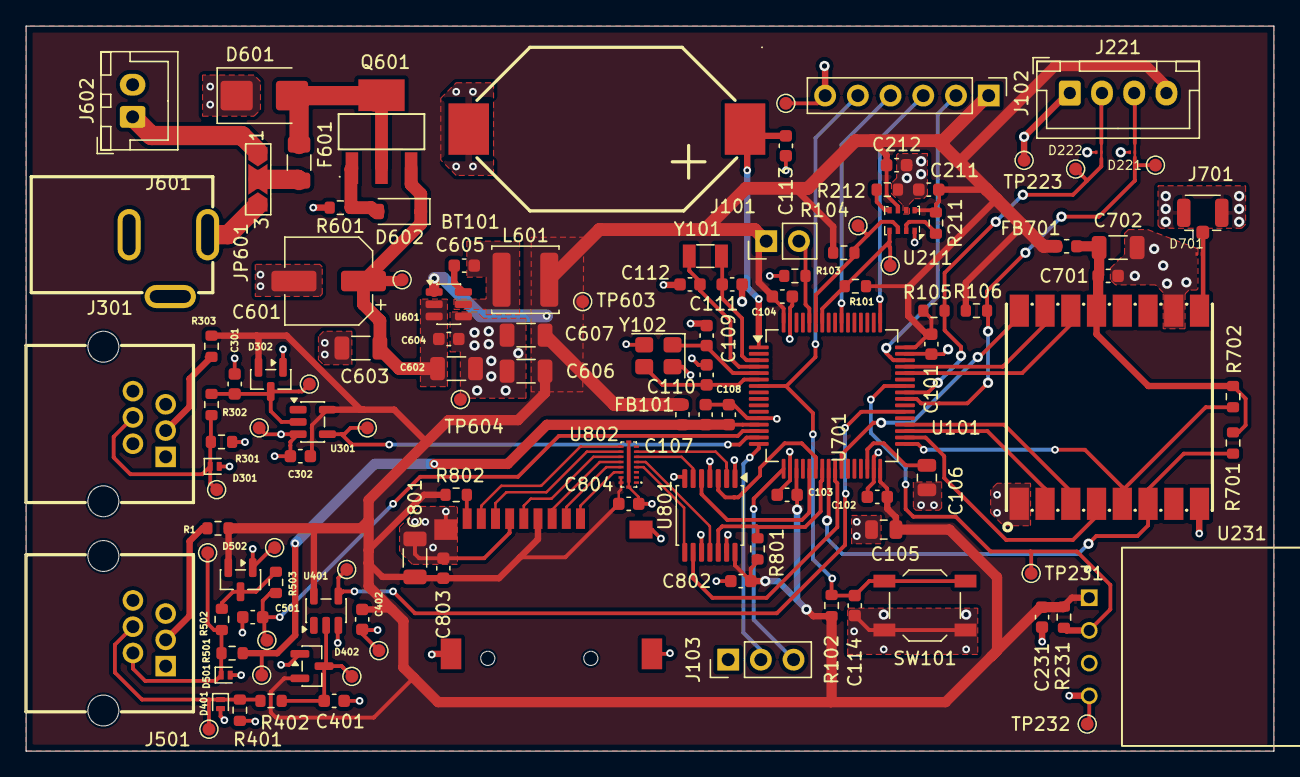
[picture p29: board estacao-meteorologica.kicad_pcb from above]

Board: 2 copper layers, 96.9 x 56.3 mm, 125 parts (0 on the bottom side), 67 nets.

Parts:
BT101: CR1225 holder, horizontal; BT_Holder_MYOUNG_BS-12-B4AK025-R
C101, C102, C103, C104, C113, C114, C211, C212, C231, C301, C302, C401, C402, C501, C701, C802, C803, C804: 100 nF; C_0603_1608Metric
C105, C106: 4.7 µF; C_0805_2012Metric
C107: 1 µF; C_0603_1608Metric
C108: 10 nF; C_0603_1608Metric
C109, C110: 15pF; C_0603_1608Metric
C111, C112: 9pF; C_0603_1608Metric
C601: 47 µF, 35 V; CP_Elec_6.3x5.8
C602, C603, C801: 10 µF, 50 V; C_1206_3216Metric
C604, C605: 100n / 50V; C_0603_1608Metric
C606, C607: 22 µF, 25 V; C_1206_3216Metric
C702: 10 µF; C_1206_3216Metric
D221, D222, D701: PESD5V0R1BSFYL; SOD-962_L0.6-W0.3-BI
D301, D401, D501: PESD5V0S1UL; D_SOD-882
D302, D402, D502: BAS70-04; SOT-23
D601: SMBJ16CA; D_SMB
D602: BZT52C10 / 10V; D_SOD-123
F601: 1.5 A, 32 V, slow-blow; Fuse_1206_3216Metric
FB101: Ferrite bead; L_0603_1608Metric
FB701: 120 Ω @ 100 MHz, 2 A; L_0603_1608Metric
H901, H902, H903, H904: M3 NPTH, Ø3.2 mm; MountingHole_3.2mm_M3
J101: Header, 1x02, P2.54 mm; PinHeader_1x02_P2.54mm_Vertical
J102: Header, 1x06, P2.54 mm; PinHeader_1x06_P2.54mm_Vertical
J103: Header, 1x03, P2.54 mm; PinHeader_1x03_P2.54mm_Vertical
J221: JST-XH, 1x04, P2.50 mm; JST_XH_B4B-XH-A_1x04_P2.50mm_Vertical
J301, J501: RJ11 6P6C, 90°; RJ11-TH_PCB-6P6C-90
J601: DC jack, 2.0 mm; DC-IN-TH_DC-005-2.0_C22459640
J602: JST-XH, 1x02, P2.50 mm; JST_XH_B2B-XH-A_1x02_P2.50mm_Vertical
J701: U.FL, 50 Ω; U.FL_Hirose_U.FL-R-SMT-1_Vertical
J801: microSD socket, TF-15x15; microSD_SOFNG_TF-15x15_C111196
JP601: Solder jumper, 3 pads; SolderJumper-3_P2.0mm_Open_TrianglePad1.0x1.5mm_NumberLabels
L601: 3.9 µH; L_APV_ANR5040
Q601: DMP6023LE-13; SOT-223-4_L6.5-W3.5-P2.30-LS7.0-BR
R1, R303, R503: 1 kΩ; R_0603_1608Metric
R101, R104, R105, R106: 4.7k; R_0603_1608Metric
R102, R103, R211, R212, R231, R301, R401, R501, R502, R701, R702, R801, R802: 10 kΩ; R_0603_1608Metric
R302, R402: 4.7 kΩ; R_0603_1608Metric
R601: 100 kΩ, 1 %; R_0603_1608Metric
SW101: Tactile switch, SPST; SW_SPST_TL3342
TP211: I2C1_SCL; TestPoint_Pad_D1.0mm
TP212: I2C1_SDA; TestPoint_Pad_D1.0mm
TP213, TP223, TP232, TP304, TP404, TP504, TP604: GND; TestPoint_Pad_D1.0mm
TP221: BH_I2C3_SCL; TestPoint_Pad_D1.0mm
TP222: BH_I2C3_SDA; TestPoint_Pad_D1.0mm
TP231: DHT22_DATA; TestPoint_Pad_D1.0mm
TP301: SENS_RAIN_RAW; TestPoint_Pad_D1.0mm
TP302: SENS_RAIN_FILTERED; TestPoint_Pad_D1.0mm
TP303: RAIN_PULSE; TestPoint_Pad_D1.0mm
TP401: SENS_WIND_SPEED_RAW; TestPoint_Pad_D1.0mm
TP402: SENS_WIND_SPEED_FILTERED; TestPoint_Pad_D1.0mm
TP403: WIND_SPEED_PULSE; TestPoint_Pad_D1.0mm
TP501: SENS_WIND_DIR_RAW; TestPoint_Pad_D1.0mm
TP502: WIND_DIR_ADC; TestPoint_Pad_D1.0mm
TP503: AVREF_SENSOR; TestPoint_Pad_D1.0mm
TP601: VIN_MAIN; TestPoint_Pad_D1.0mm
TP603: +3V3; TestPoint_Pad_D1.0mm
U101: STM32F446RET6; LQFP-64_10x10mm_P0.5mm
U211: BMP280; Bosch_LGA-8_2x2.5mm_P0.65mm_ClockwisePinNumbering
U231: DHT22; DHT22_THT_P2.54mm_Vertical
U301, U401: SN74LVC1G17DBVR; SOT-23-5
U601: AP63203WU-7; TSOT-23-6
U701: LORA1276-C1-915MHZ; COMM-SMD_LORA1276-C1-915MHZ
U801: SN74LVC125APWR; TSSOP-14_4.4x5mm_P0.65mm
U802: EMIF06-MSD02N16; QFN-16L_L3.5-W1.2-P0.40_EMIF06-MSD02N16
Y101: 32.768 kHz, CL 7 pF; Crystal_SMD_3215-2Pin_3.2x1.5mm
Y102: 8 MHz, CL 10 pF; Crystal_SMD_3225-4Pin_3.2x2.5mm

Connections:
+3V3: C101.1, C102.1, C103.1, C104.1, C105.1, C211.1, C212.1, C231.1, C302.1, C402.1, C606.1, C607.1, C801.1, C802.1, C803.1, C804.1, D302.2 (K), D402.2 (K), D502.2 (K), FB101.1, FB701.1, J101.1, J102.1, J221.4, J801.4 (VDD), L601.2, R1.2, R101.1, R102.1, R104.1, R105.1, R106.1, R211.1, R231.2, R303.1, R801.2, R802.2, TP603.1, U101.19 (VDD), U101.32 (VDD), U101.48 (VDD), U101.64 (VDD), U211.6 (VDDIO), U211.8 (VDD), U231.1 (VDD), U301.5 (VCC), U401.5 (VCC), U601.1 (FB), U801.14 (VCC), U802.16 (VCC), U802.17 (RDAT_VCC)
/ALIMENTAÇÃO/VIN_EXTERNAL: J602.1, JP601.1 (A)
/ALIMENTAÇÃO/VIN_JACK: J601.1, JP601.3 (B)
/ALIMENTAÇÃO/VIN_MAIN: C601.1, C602.1, C603.1, C604.1, D602.1 (K), Q601.3 (S), TP601.1, U601.2 (EN), U601.3 (IN)
/ALIMENTAÇÃO/V_SW: C605.2, L601.1, U601.5 (SW)
/BH1750_INTERFACE/BH_I2C3_SCL: D222.2 (A2), J221.2, R105.2, TP222.1, U101.41 (PA8)
/BH1750_INTERFACE/BH_I2C3_SDA: D221.2 (A2), J221.3, R106.2, TP221.1, U101.40 (PC9)
/CARTÃO microSD/SD_CD: J801.9 (DET_B), R802.1
/CARTÃO microSD/SD_MISO: U101.22 (PA6), U801.3
/CARTÃO microSD/SD_SCK: U101.21 (PA5), U801.5
/CARTÃO microSD/SD_SPI_CS: U101.25 (PC5), U801.9
/CARTÃO microSD/SD_SPI_MOSI: R801.1, U101.23 (PA7), U801.12
/INTERFACES METEOROLÓGICAS/PLUVIÔMETRO/SENS_RAIN_RAW: D301.1 (K), J301.4, R301.2, R302.1, TP301.1
/INTERFACES METEOROLÓGICAS/RAIN_PULSE: TP303.1, U101.15 (PA1), U301.4
/INTERFACES METEOROLÓGICAS/WIND_DIR_ADC: C501.1, R503.2, TP502.1, U101.14 (PA0)
/INTERFACES METEOROLÓGICAS/WIND_SPEED_PULSE: TP403.1, U101.38 (PC7), U401.4
/MCU E DEPURAÇÃO/DHT22_DATA: R231.1, TP231.1, U101.42 (PA9), U231.2 (DATA)
/MCU E DEPURAÇÃO/I2C1_SCL: R101.2, TP211.1, U101.58 (PB6), U211.4 (SCK)
/MCU E DEPURAÇÃO/I2C1_SDA: R104.2, TP212.1, U101.59 (PB7), U211.3 (SDI)
/MCU E DEPURAÇÃO/LORA_DIO0: U101.44 (PA11), U701.14 (DIO0)
/MCU E DEPURAÇÃO/LORA_DIO1: U101.45 (PA12), U701.15 (DIO1)
/MCU E DEPURAÇÃO/LORA_DIO2: U101.26 (PB0), U701.16 (DIO2)
/MCU E DEPURAÇÃO/LORA_NSS: R701.2, U101.33 (PB12), U701.5 (NSS)
/MCU E DEPURAÇÃO/LORA_RST: R702.2, U101.24 (PC4), U701.6 (NRESET)
/MCU E DEPURAÇÃO/LORA_SPI_MISO: U101.35 (PB14), U701.2 (MISO)
/MCU E DEPURAÇÃO/LORA_SPI_MOSI: U101.36 (PB15), U701.3 (MOSI)
/MCU E DEPURAÇÃO/LORA_SPI_SCK: U101.34 (PB13), U701.4 (SCK)
/RÁDIO LoRa/+3V3_LORA: C701.1, C702.1, FB701.2, R701.1, R702.1, U701.13 (VCC)
/RÁDIO LoRa/RF_ANT_915: D701.2 (A2), J701.1 (In), U701.9 (ANT)
AVREF_SENSOR: C107.1, C108.1, FB101.2, R501.1, TP503.1, U101.13 (VDDA)
BMP_CSB: R211.2, U211.2 (CSB)
BMP_SDO: R212.2, U211.5 (SDO)
BOOT0: J101.2, R103.1, U101.60 (BOOT0)
GND: BT101.2 (-), C101.2, C102.2, C103.2, C104.2, C105.2, C106.2, C107.2, C108.2, C109.1, C110.1, C111.1, C112.1, C113.2, C114.2, C211.2, C212.2, C231.2, C301.2, C302.2, C401.2, C402.2, C501.2, C601.2, C602.2, C603.2, C604.2, C606.2, C607.2, C701.2, C702.2, C801.2, C802.2, C803.2, C804.2, D221.1 (A1), D222.1 (A1), D301.2 (A), D302.1 (A), D401.2 (A), D402.1 (A), D501.2 (A), D502.1 (A), D601.1 (A1), D701.1 (A1), J102.6, J103.1, J221.1, J501.5, J601.2, J602.2, J701.2 (Ext), J801.6 (VSS), J801.10 (DET_A), J801.11 (SHIELD), J801.12 (SHIELD), J801.13 (SHIELD), R103.2, R212.1, R301.1, R401.1, R601.2, SW101.2, TP213.1, TP223.1, TP232.1, TP304.1, TP404.1, TP504.1, TP604.1, U101.12 (VSSA), U101.18 (VSS), U101.31 (VSS), U101.47 (VSS), U101.63 (VSS), U211.1 (GND), U211.7 (GND), U231.4 (GND), U301.3 (GND), U401.3 (GND), U601.4 (GND), U701.1 (GND), U701.8 (GND), U701.10 (GND), U801.1, U801.4, U801.7 (GND), U801.10, U801.13, U802.9 (GND), U802.18 (GND), U802.19 (GND), Y102.2, Y102.4
NRST: C114.1, J102.5, R102.2, SW101.1, U101.7 (NRST)
unnamed: C301.1, D302.3 (COM), R302.2, TP302.1, U301.2
unnamed: C401.1, D402.3 (COM), R402.2, TP402.1, U401.2
unnamed: D501.1 (K), J501.2, R501.2, R502.1, TP501.1
unnamed: D502.3 (COM), R502.2, R503.1
unnamed: D601.2 (A2), F601.2, Q601.2 (D), Q601.4 (D)
unnamed: D602.2 (A), Q601.1 (G), R601.1
unnamed: J301.3, R303.2
unnamed: J501.3, R1.1
unnamed: F601.1, JP601.2 (C)
unnamed: C111.2, U101.3 (PC14), Y101.2
unnamed: C112.2, U101.4 (PC15), Y101.1
unnamed: C109.2, U101.5 (PH0), Y102.1
unnamed: C110.2, U101.6 (PH1), Y102.3
unnamed: C106.1, U101.30 (VCAP_1)
unnamed: C605.1, U601.6 (BST)
RXD: J103.3, U101.17 (PA3)
SD_CARD_CS: J801.2 (DAT3/CD), U802.14 (DAT3_EX)
SD_CARD_DAT1: J801.8 (SD_CARD_DAT1), U802.10 (DAT1_EX)
SD_CARD_DAT2: J801.1 (SD_CARD_DAT2), U802.15 (DAT2_EX)
SD_CARD_MISO: J801.7 (DAT0), U802.11 (DAT0_EX)
SD_CARD_MOSI: J801.3 (CMD), U802.13 (CMD_EX)
SD_CARD_SCK: J801.5 (CLK), U802.12 (CLK_EX)
SD_CS_BUF: U801.8, U802.4 (DAT3_IN)
SD_MISO_BUF: U801.2, U802.7 (DAT0_IN)
SD_MOSI_BUF: U801.11, U802.5 (CMD_IN)
SD_SCK_BUF: U801.6, U802.6 (CLK_IN)
SENS_WIND_SPEED_RAW: D401.1 (K), J501.4, R401.2, R402.1, TP401.1
SWCLK: J102.3, U101.49 (PA14)
SWDIO: J102.2, U101.46 (PA13)
SWO: J102.4, U101.55 (PB3)
TXD: J103.2, U101.16 (PA2)
VBAT: BT101.1 (+), C113.1, U101.1 (VBAT)
