vitorr-hugoo/TCC/Hardware/esquematico_V4.kicad_pcb

## KiCad design Hardware/esquematico_V4.kicad_pcb (2026-09-19)

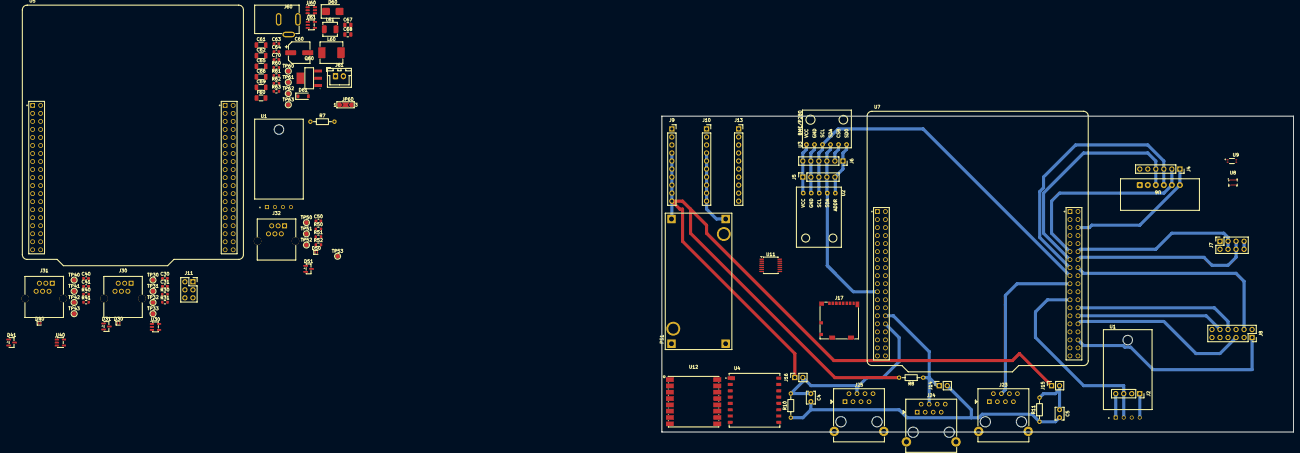
[picture p30: board esquematico_V4.kicad_pcb from above]

Board: 2 copper layers, 200.0 x 100.0 mm, 101 parts (0 on the bottom side), 49 nets.

Parts:
C4, C5: 100n; C_Disc_D3.8mm_W2.6mm_P2.50mm
C30, C31, C41: 100n; C_0603_1608Metric
C40, C50: 10n; C_0603_1608Metric
C60: 47u / 35V; CP_Elec_6.3x5.8
C61, C62: 10u / 50V; C_1206_3216Metric
C63, C64: 100n / 50V; C_0603_1608Metric
C65, C66, C69: 22u / 25V; C_1206_3216Metric
C67, C68: 10u / 25V; C_0805_2012Metric
C70: 6p8 / 50V; C_0603_1608Metric
D30, D40, D50: PESD5V0S1UL; D_SOD-882
D31, D41, D51: BAS70-04; SOT-23
D60: SMBJ16CA; D_SMB
D61: BZT52C10 / 10V; D_SOD-123
F60: 1.5A / 32V lento; Fuse_1206_3216Metric
J2: Conn_DHT; PinSocket_1x04_P2.54mm_Vertical
J4: Conn_cartao_SD; PinSocket_1x06_P2.54mm_Vertical
J5: Conn_BH1750; PinSocket_1x05_P2.54mm_Vertical
J6: Conn_BMP; PinSocket_1x06_P2.54mm_Vertical
J7: Conn_Lora_4; PinSocket_2x04_P2.54mm_Vertical
J8: Conn_02x06_Row_Letter_Last; PinSocket_2x06_P2.54mm_Vertical
J9: Conn_+3v3; PinSocket_1x10_P2.54mm_Vertical
J10: Conn_GND; PinSocket_1x10_P2.54mm_Vertical
J11: Conn_01x02_Socket; PinSocket_2x03_P2.54mm_Vertical
J13: Conn_+5V; PinSocket_1x10_P2.54mm_Vertical
J14, J15, J16: Conn_01x02_Socket; PinSocket_1x02_P2.54mm_Vertical
J17: Micro_SD_Card; microSD_HC_Molex_104031-0811
J23, J24, J25: RJ45; RJ45_RCH_RC01937
J30, J31, J32: R-RJ11R06P-A800; RJ11-TH_PCB-6P6C-90
J60: P4 / DC-005-2.0; DC-IN-TH_DC-005-2.0_C22459640
J61: J_PWR / JST-XH; JST_XH_B2B-XH-A_1x02_P2.50mm_Vertical
JP60: SEL_FONTE; SolderJumper-3_P2.0mm_Open_TrianglePad1.0x1.5mm_NumberLabels
L60: 4u7 / MWSA0603S; L_Sunlord_MWSA0603S
L61: 2u2 / MWSA0402S; L_Sunlord_MWSA0402S
PS1: Lm2596; LM2596_modulo
Q60: DMP6023LE-13; SOT-223-4_L6.5-W3.5-P2.30-LS7.0-BR
R7, R8, R10, R11: 10k; R_Axial_DIN0204_L3.6mm_D1.6mm_P7.62mm_Horizontal
R30, R40, R50, R51: 10k; R_0603_1608Metric
R31, R41: 4k7; R_0603_1608Metric
R52: 1k; R_0603_1608Metric
R60, R63: 100k / 1%; R_0603_1608Metric
R61: 300k / 1%; R_0603_1608Metric
R62: 150k / 1%; R_0603_1608Metric
TP30: PLUVIOMETRO_RAW; TestPoint_Pad_D1.5mm
TP31: PLUVIOMETRO_FILT; TestPoint_Pad_D1.5mm
TP32: RAIN_PULSE; TestPoint_Pad_D1.5mm
TP33, TP43, TP53, TP63: GND; TestPoint_Pad_D1.5mm
TP40: ANEMOMETRO_RAW; TestPoint_Pad_D1.5mm
TP41: ANEMOMETRO_FILT; TestPoint_Pad_D1.5mm
TP42: WIND_SPEED_PULSE; TestPoint_Pad_D1.5mm
TP50: WIND_DIR_RAW; TestPoint_Pad_D1.5mm
TP51: WIND_DIR_ADC; TestPoint_Pad_D1.5mm
TP52: VREF_SENSOR; TestPoint_Pad_D1.5mm
TP60: VIN_MAIN; TestPoint_Pad_D1.5mm
TP61: +5V; TestPoint_Pad_D1.5mm
TP62: +3V3; TestPoint_Pad_D1.5mm
U1, U1#2: DHT22; XDCR_DHT22
U2: module_bh1750; bh1750_modulo
U3: module_bme280; bme280_modulo
U4: Lora_Sx1276; SX1276_modulo
U5, U7: NUCLEO-F446RE; MODULE_NUCLEO-F446RE
U6: MicroSD Card Adapter; Micro_SD_Card_Adapter
U8: BMP280; Bosch_LGA-8_2x2.5mm_P0.65mm_ClockwisePinNumbering
U9: BH1750FVI-TR; BH1750FVI-TR_sensor
U11: 74LVC125; TSSOP-14_4.4x5mm_P0.65mm
U12: LORA1276-C1-915MHZ; COMM-SMD_LORA1276-C1-915MHZ
U30, U40: SN74LVC1G17DBVR; SOT-23-5
U60: AP63205WU-7; TSOT-23-6
U61: TLV62569DBVR; SOT-23-5

Connections:
+3V3: C31.1, C41.1, C68.1, C69.1, C70.1, D31.2 (K), D41.2 (K), D51.2 (K), J5.1, J6.2, J6.6, J7.7, J7.8, J9.1, J9.2, J9.3, J9.4, J9.5, J9.6, J9.7, J9.8, J9.9, J9.10, J15.1, J16.1, J17.4 (VDD), L61.2, PS1.OUT+, R8.2, R30.1, R40.1, R61.1, TP62.1, U2.5 (VCC), U3.1 (VCC), U3.5 (CSB), U4.3 (3.3V), U8.6 (VDDIO), U9.1 (VCC), U11.7 (GND), U12.13 (VCC), U30.5 (VCC), U40.5 (VCC)
+5V: C65.1, C66.1, C67.1, J4.5, L60.2, R7.2, TP61.1, U1#2.1 (VDD), U5.CN7_18 (CN7_+5V), U6.2 (VCC), U11.14 (VCC), U60.1 (FB), U61.1 (EN), U61.4 (VIN)
/DHT22/PA8: R7.1, U1#2.2 (DATA)
/METEOROLOGIA/ANEMOMETRO/ANEMOMETRO_RAW: D40.1 (K), J31.4, R40.2, R41.1, TP40.1
/METEOROLOGIA/BIRUTA/WIND_DIR_RAW: D50.1 (K), J32.4, R50.2, R51.1, TP50.1
/METEOROLOGIA/PLUVIOMETRO/PLUVIOMETRO_RAW: D30.1 (K), J30.4, R30.2, R31.1, TP30.1
/alimentacao/ENERGIA_POS: J61.1, JP60.1 (A)
/alimentacao/FB_3V3: C70.2, R62.2, R63.1, U61.5 (FB)
/alimentacao/P4_POS: J60.1, JP60.3 (B)
/alimentacao/VIN_MAIN: C60.1, C61.1, C62.1, C63.1, D61.1 (K), Q60.3 (S), TP60.1, U60.2 (EN), U60.3 (IN)
ANT_EXT: U4.1 (ANT), U12.9 (ANT)
CS_LLS: J17.2 (DAT3/CD), U11.11
DI_LLS: J17.3 (CMD), U11.3
DO_LLS: J17.7 (DAT0), U11.5
GND: C30.2, C31.2, C40.2, C41.2, C50.2, C60.2, C61.2, C62.2, C63.2, C65.2, C66.2, C67.2, C68.2, C69.2, D30.2 (A), D31.1 (A), D40.2 (A), D41.1 (A), D50.2 (A), D51.1 (A), D60.1 (A1), J4.6, J5.2, J5.5, J6.1, J6.5, J17.6 (VSS), J17.10 (DET_A), J17.11 (SHIELD), J30.3, J31.3, J32.3, J60.2, J61.2, R60.2, R63.2, TP33.1, TP43.1, TP53.1, TP63.1, U1#2.4 (GND), U2.1 (ADDR), U2.4 (GND), U3.2 (GND), U3.6 (SDO), U5.CN7_8 (CN7_GND), U5.CN7_19 (CN7_GND), U5.CN7_20 (CN7_GND), U5.CN7_22 (CN7_GND), U5.CN10_9 (CN10_GND), U5.CN10_20 (CN10_GND), U5.CN10_32 (AGND), U6.1 (GND), U8.1 (GND), U8.7 (GND), U9.3 (GND), U11.1, U11.4, U11.10, U11.13, U12.1 (GND), U12.8 (GND), U12.10 (GND), U30.3 (GND), U40.3 (GND), U60.4 (GND), U61.2 (GND)
Gnd: C4.2, C5.2, J2.1, J8.11, J8.12, J10.1, J10.2, J10.3, J10.4, J10.5, J10.6, J10.7, J10.8, J10.9, J10.10, J14.2, PS1.IN-, PS1.OUT-, R10.1, R11.1, U1.4 (GND), U4.2 (GND), U4.9 (GND), U4.16 (GND), U7.CN7_8 (CN7_GND), U7.CN7_19 (CN7_GND), U7.CN7_20 (CN7_GND), U7.CN7_22 (CN7_GND), U7.CN10_9 (CN10_GND), U7.CN10_20 (CN10_GND)
unnamed: C30.1, D31.3 (COM), R31.2, TP31.1, U30.2
unnamed: C40.1, D41.3 (COM), R41.2, TP41.1, U40.2
unnamed: D51.3 (COM), R51.2, R52.1
unnamed: D60.2 (A2), F60.2, Q60.2 (D), Q60.4 (D)
unnamed: D61.2 (A), Q60.1 (G), R60.1
unnamed: F60.1, JP60.2 (C)
unnamed: R61.2, R62.1
unnamed: C64.1, U60.6 (BST)
unnamed: C64.2, L60.1, U60.5 (SW)
unnamed: L61.1, U61.3 (SW)
PA0: J14.1, J24.4, R8.1, U7.CN7_28 (PA0)
PA1: C4.1, J16.2, J25.4, R10.2, U7.CN7_30 (PA1)
PA5: J4.2, U5.CN10_11 (PA5), U6.5 (SCK), U7.CN10_11 (PA5)
PA6: J4.4, U5.CN10_13 (PA6), U6.3 (MISO), U7.CN10_13 (PA6)
PA7: J4.3, U5.CN10_15 (PA7), U6.4 (MOSI), U7.CN10_15 (PA7)
PA8: J2.3, U1.2 (DATA), U5.CN10_23 (PA8), U7.CN10_23 (PA8)
PA11: J7.5, J7.6, U4.5 (DIO0), U5.CN10_14 (PA11), U7.CN10_14 (PA11)
PA12: J7.3, J7.4, U4.6 (DIO1), U5.CN10_12 (PA12), U7.CN10_12 (PA12)
PB6: J5.3, J6.4, J11.1, J11.2, J11.3, U2.3 (SCL), U3.3 (SCL)
PB7: J5.4, J6.3, J11.4, J11.5, J11.6, U2.2 (SDA), U3.4 (SDA)
PB12: J8.3, J8.4, U4.15 (NSS), U5.CN10_16 (PB12), U7.CN10_16 (PB12)
PB13: J8.5, J8.6, U4.12 (SCK), U5.CN10_30 (PB13), U7.CN10_30 (PB13)
PB14: J8.9, J8.10, U4.13 (MISO), U5.CN10_28 (PB14), U7.CN10_28 (PB14)
PB15: J8.7, J8.8, U4.14 (MOSI), U5.CN10_26 (PB15), U7.CN10_26 (PB15)
PC4: J8.1, J8.2, U4.4 (RESET), U5.CN10_34 (PC4), U7.CN10_34 (PC4)
PC5: J4.1, U5.CN10_6 (PC5), U6.6 (CS), U7.CN10_6 (PC5)
PC7: C5.1, J15.2, J23.4, R11.2, U7.CN10_19 (PC7)
RAIN_PULSE: TP32.1, U5.CN7_30 (PA1), U30.4
SCK_LLS: J17.5 (CLK), U11.8
VCC: J2.4, J13.1, J13.2, J13.3, J13.4, J13.5, J13.6, J13.7, J13.8, J13.9, J13.10, U1.1 (VDD), U7.CN7_18 (CN7_+5V)
VREF_SENSOR: R50.1, TP52.1, U5.CN10_7 (AVDD)
WIND_DIR_ADC: C50.1, R52.2, TP51.1, U5.CN7_28 (PA0)
WIND_SPEED_PULSE: TP42.1, U5.CN10_19 (PC7), U40.4
