vitorr-hugoo/TCC/firmware/stm32/Core/Inc/main.h

#define PLUV_RAIN_Pin GPIO_PIN_1
#define PLUV_RAIN_GPIO_Port GPIOA
#define PLUV_RAIN_EXTI_IRQn EXTI1_IRQn
#define USART_TX_Pin GPIO_PIN_2
#define USART_TX_GPIO_Port GPIOA
#define USART_RX_Pin GPIO_PIN_3
#define USART_RX_GPIO_Port GPIOA
#define LORA_RST_Pin GPIO_PIN_4
#define LORA_RST_GPIO_Port GPIOC
#define SD_CS_Pin GPIO_PIN_5
#define SD_CS_GPIO_Port GPIOC
#define LORA_NSS_Pin GPIO_PIN_12
#define LORA_NSS_GPIO_Port GPIOB
#define ANEM_SPEED_Pin GPIO_PIN_7
#define ANEM_SPEED_GPIO_Port GPIOC
#define ANEM_SPEED_EXTI_IRQn EXTI9_5_IRQn
#define DHT22_Pin GPIO_PIN_8
#define DHT22_GPIO_Port GPIOA
#define LORA_DIO0_Pin GPIO_PIN_11
#define LORA_DIO0_GPIO_Port GPIOA
#define LORA_DIO0_EXTI_IRQn EXTI15_10_IRQn
#define LORA_DIO1_Pin GPIO_PIN_12
#define LORA_DIO1_GPIO_Port GPIOA
#define LORA_DIO1_EXTI_IRQn EXTI15_10_IRQn
#define TMS_Pin GPIO_PIN_13
#define TMS_GPIO_Port GPIOA
#define TCK_Pin GPIO_PIN_14
#define TCK_GPIO_Port GPIOA
#define SWO_Pin GPIO_PIN_3
#define SWO_GPIO_Port GPIOB
