vitorr-hugoo/TCC/(commit log)

2026-09-11 Corrige nomes e caminhos do projeto STM32
2026-09-11 Implementa diagnostico dos sensores e valida TX LoRa com NSS em PB12
    - Verifica comunicacao SPI, configuracao do SX1276 e conclusao local de TX.
    - Corrige NSS para PB12 no CubeMX, referencias de pinagem e testes.
    - Aguarda confirmacao de RegOpMode por ate 10 ms, sem atraso fixo ou ocultar falhas.
    - Adiciona diagnostico continuo dos seis sensores, validade por amostra e logs de transicao no SD/serial.
    - Isola falhas individuais e protege conversoes numericas, mantendo payload de 18 bytes sem ACK.
    - Valida tamanho, CRC e origem dos pacotes no gateway e monitora ausencia de recepcao.
    - Inclui testes automatizados, planos e relatorios da implementacao.
    Validacao: 54 testes LoRa e 75 de sensores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
2026-09-12 hardware: inicia PCB V2
2026-09-12 hardware: adiciona sensores e cartao SD
2026-09-15 add circuito cartão sd
2026-09-17 add sensores metereológicos - ajuda GPT
2026-09-17 Sensores metereologicos -IA que fez
2026-09-19 design sensores pronto
2026-09-19 chore(firmware): adiciona guias de validacao e qualidade
2026-09-22 security: restaura modelo seguro de credenciais
2026-09-25 refatoracao: atualizacoes de hardware e falta revisao LoRa
2026-09-26 Padronizacao de nomes e numero de componentes
2026-09-26 Ajuste de componentes por folha
2026-09-27 Refact - mudança do sensor bh1750 para placa filha e conector jst + reposicionamento do sensor DHT22 para reduzir influencia de temperatura interna da placa
2026-09-27 Add test points necessarios para debug
2026-09-27 Refact: tirei estagio de 12V -> 5V e agora é direto 12V -> 3V
2026-10-03 feat(hardware): consolida revisão PCB V2
2026-10-03 Add AGENTS.md para coordenação entre divisões do projeto
2026-10-08 Finalizado layout PCBV2
